BtheDestroyer/PICOnsole/README.md

# PICOnsole

Simple OS made from scratch for the Raspberry Pi Pico with the intention of being used to launch games.
