BtheDestroyer/PICOnsole/models/DPad.stl

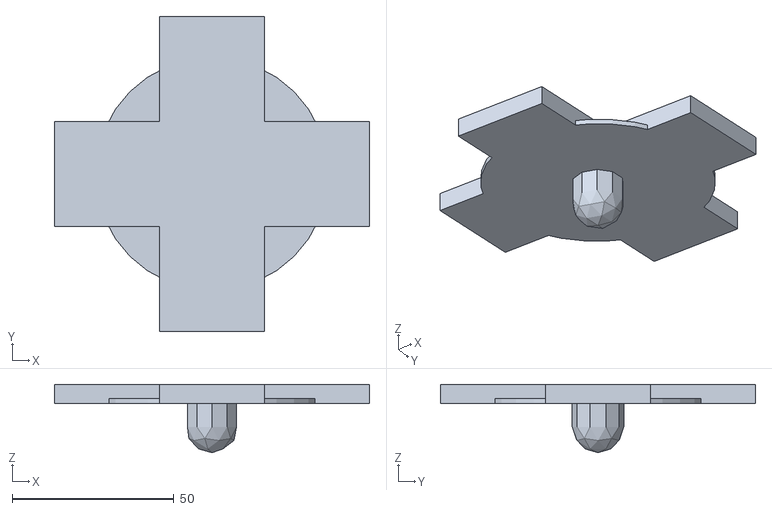
[picture p1: CAD file, 2023-11-23]
models/DPad.stl
97.5 x 97.5 x 21.2
