BtheDestroyer/PICOnsole/models/DevkitTestbench.stl

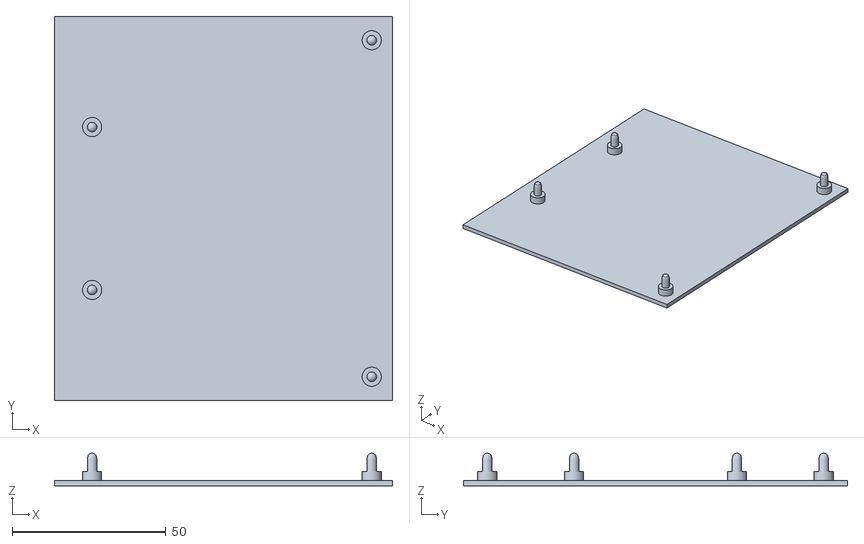
[picture p2: CAD file, 2023-11-23]
models/DevkitTestbench.stl
110.0 x 125.0 x 10.7
