BtheDestroyer/PICOnsole/(list of files, cad)

Other CAD files:
models/DPad.blend
models/DevkitTestbench.blend
