BtheDestroyer/PICOnsole/(threads)

Thread 4 (2023-02-04):

Button input

BtheDestroyer, 2023-02-04:
New class `InputMap` contains everything from the [prototype's `OS.inputs`](https://github.com/BtheDestroyer/PICOnsole/blob/main/Prototype/PICOnsole.py#L362)

New function `InputMap::evaluate` will replace the [prototype's `OS._update_input`](https://github.com/BtheDestroyer/PICOnsole/blob/main/Prototype/PICOnsole.py#L590)

Closed 2023-03-27.
