BtheDestroyer/PICOnsole/KiCad/Devkit/Hotswap Pico Hub/DevkitHotswapPicoHub.kicad_pcb

## KiCad design KiCad/Devkit/Hotswap Pico Hub/DevkitHotswapPicoHub.kicad_pcb (2023-11-23)

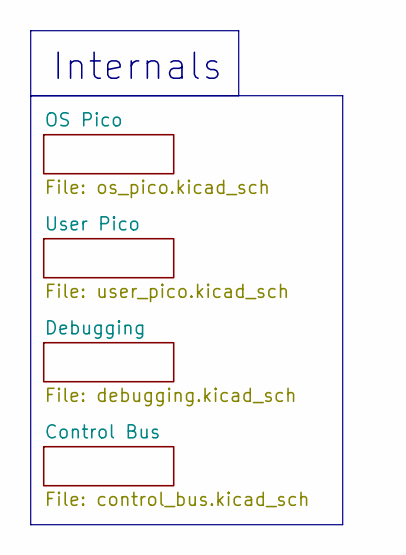
[picture p3: schematic DevkitHotswapPicoHub.kicad_sch, PICOnsole]

Notes on the sheet:
Internals

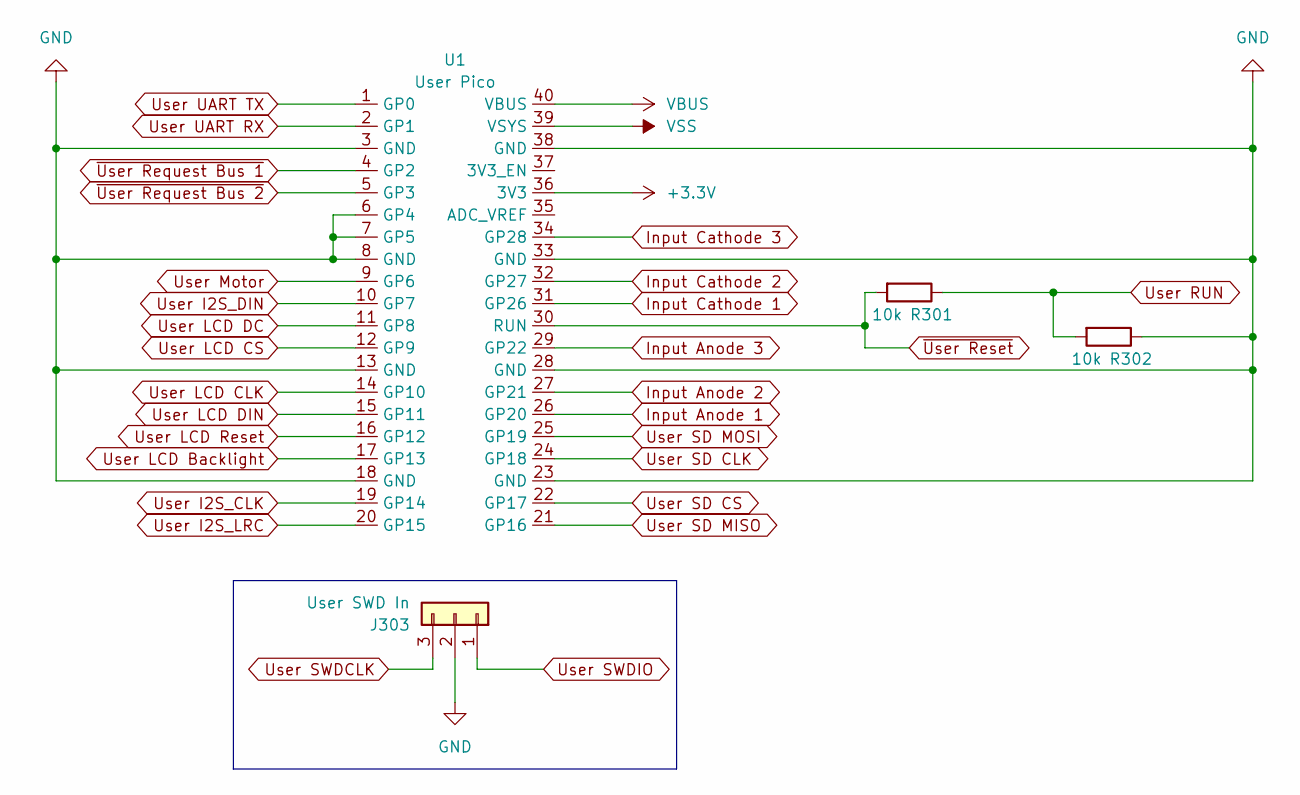
[picture p4: schematic user_pico.kicad_sch]

Parts:
J303: User SWD In; PinHeader_1x03_P2.54mm_Vertical
R301, R302: 10k; R_0805_2012Metric
U1: User Pico; Raspberry_Pi_Pico

Connections:
GND: J303.2, R302.1; also elsewhere on the board
User RUN: R301.1, R302.2; also elsewhere on the board
User SWDCLK: J303.3; also elsewhere on the board
User SWDIO: J303.1; also elsewhere on the board
~User Reset: R301.2; also elsewhere on the board

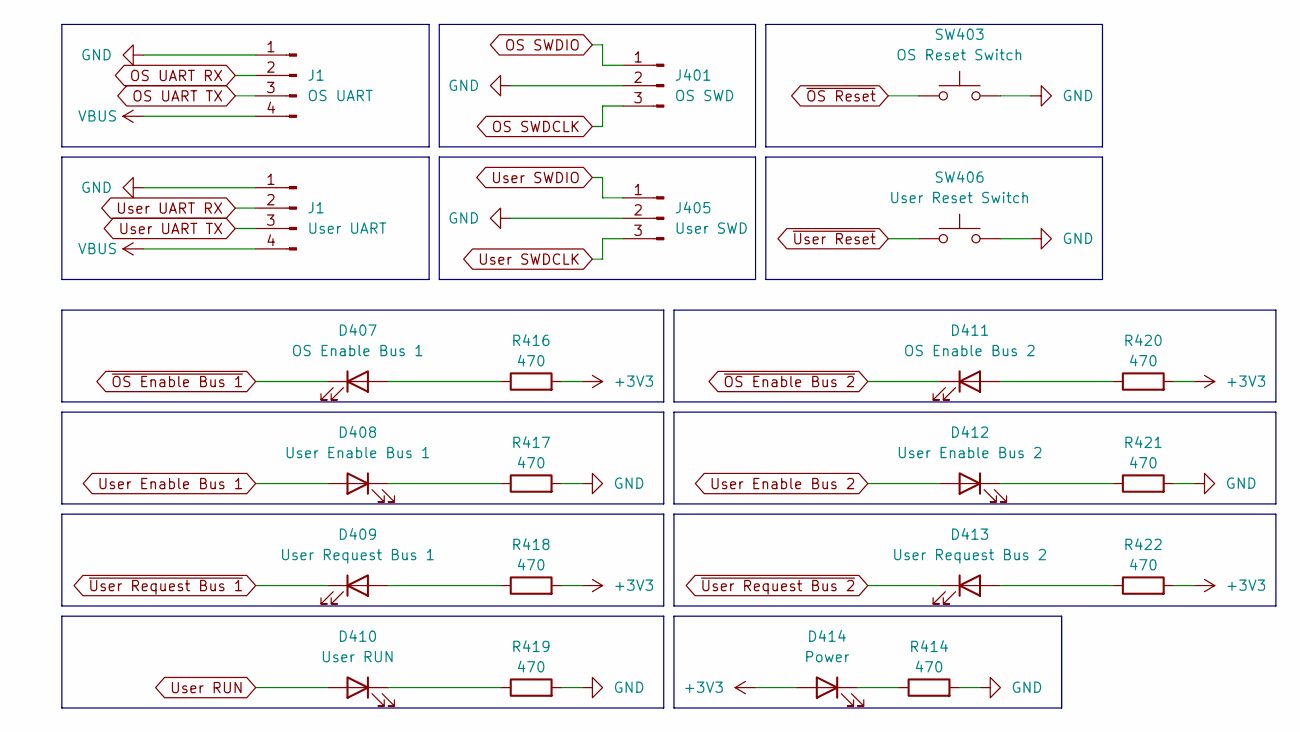
[picture p5: schematic debugging.kicad_sch]

Parts:
D407: OS Enable Bus 1; LED_D5.0mm
D408: User Enable Bus 1; LED_D5.0mm
D409: User Request Bus 1; LED_D5.0mm
D410: User RUN; LED_D5.0mm
D411: OS Enable Bus 2; LED_D5.0mm
D412: User Enable Bus 2; LED_D5.0mm
D413: User Request Bus 2; LED_D5.0mm
D414: Power; LED_D5.0mm
J1: OS UART; PinHeader_1x04_P2.54mm_Vertical
J401: OS SWD; PinSocket_1x03_P2.54mm_Vertical
J405: User SWD; PinSocket_1x03_P2.54mm_Vertical
R414, R416, R417, R418, R419, R420, R421, R422: 470; R_0805_2012Metric
SW403: OS Reset Switch; SW_PUSH-12mm
SW406: User Reset Switch; SW_PUSH-12mm

Connections:
GND: J401.2, J405.2, R414.2, R417.2, R419.2, R421.2, SW403.1, SW406.2; also elsewhere on the board
unnamed: D407.2 (A), R416.1
unnamed: D408.1 (K), R417.1
unnamed: D409.2 (A), R418.1
unnamed: D410.1 (K), R419.1
unnamed: D411.2 (A), R420.1
unnamed: D412.1 (K), R421.1
unnamed: D413.2 (A), R422.1
unnamed: D414.1 (K), R414.1
OS SWDCLK: J401.3; also elsewhere on the board
OS SWDIO: J401.1; also elsewhere on the board
User Enable Bus 1: D407.1 (K), D408.2 (A); also elsewhere on the board
User Enable Bus 2: D411.1 (K), D412.2 (A); also elsewhere on the board
User RUN: D410.2 (A); also elsewhere on the board
User SWDCLK: J405.3; also elsewhere on the board
User SWDIO: J405.1; also elsewhere on the board
~OS Reset: SW403.2; also elsewhere on the board
~User Request Bus 1: D409.1 (K); also elsewhere on the board
~User Request Bus 2: D413.1 (K); also elsewhere on the board
~User Reset: SW406.1; also elsewhere on the board

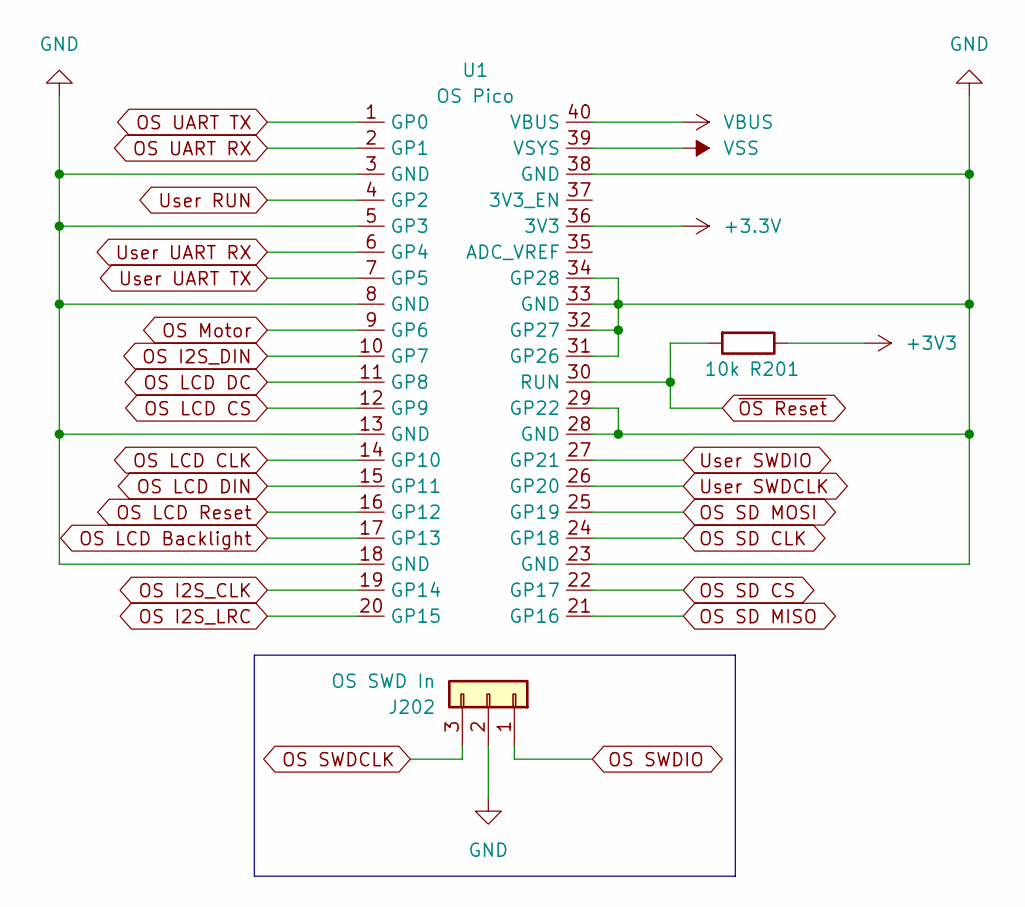
[picture p6: schematic os_pico.kicad_sch]

Parts:
J202: OS SWD In; PinHeader_1x03_P2.54mm_Vertical
R201: 10k; R_0805_2012Metric
U1: OS Pico; Raspberry_Pi_Pico

Connections:
GND: J202.2; also elsewhere on the board
OS SWDCLK: J202.3; also elsewhere on the board
OS SWDIO: J202.1; also elsewhere on the board
~OS Reset: R201.2; also elsewhere on the board

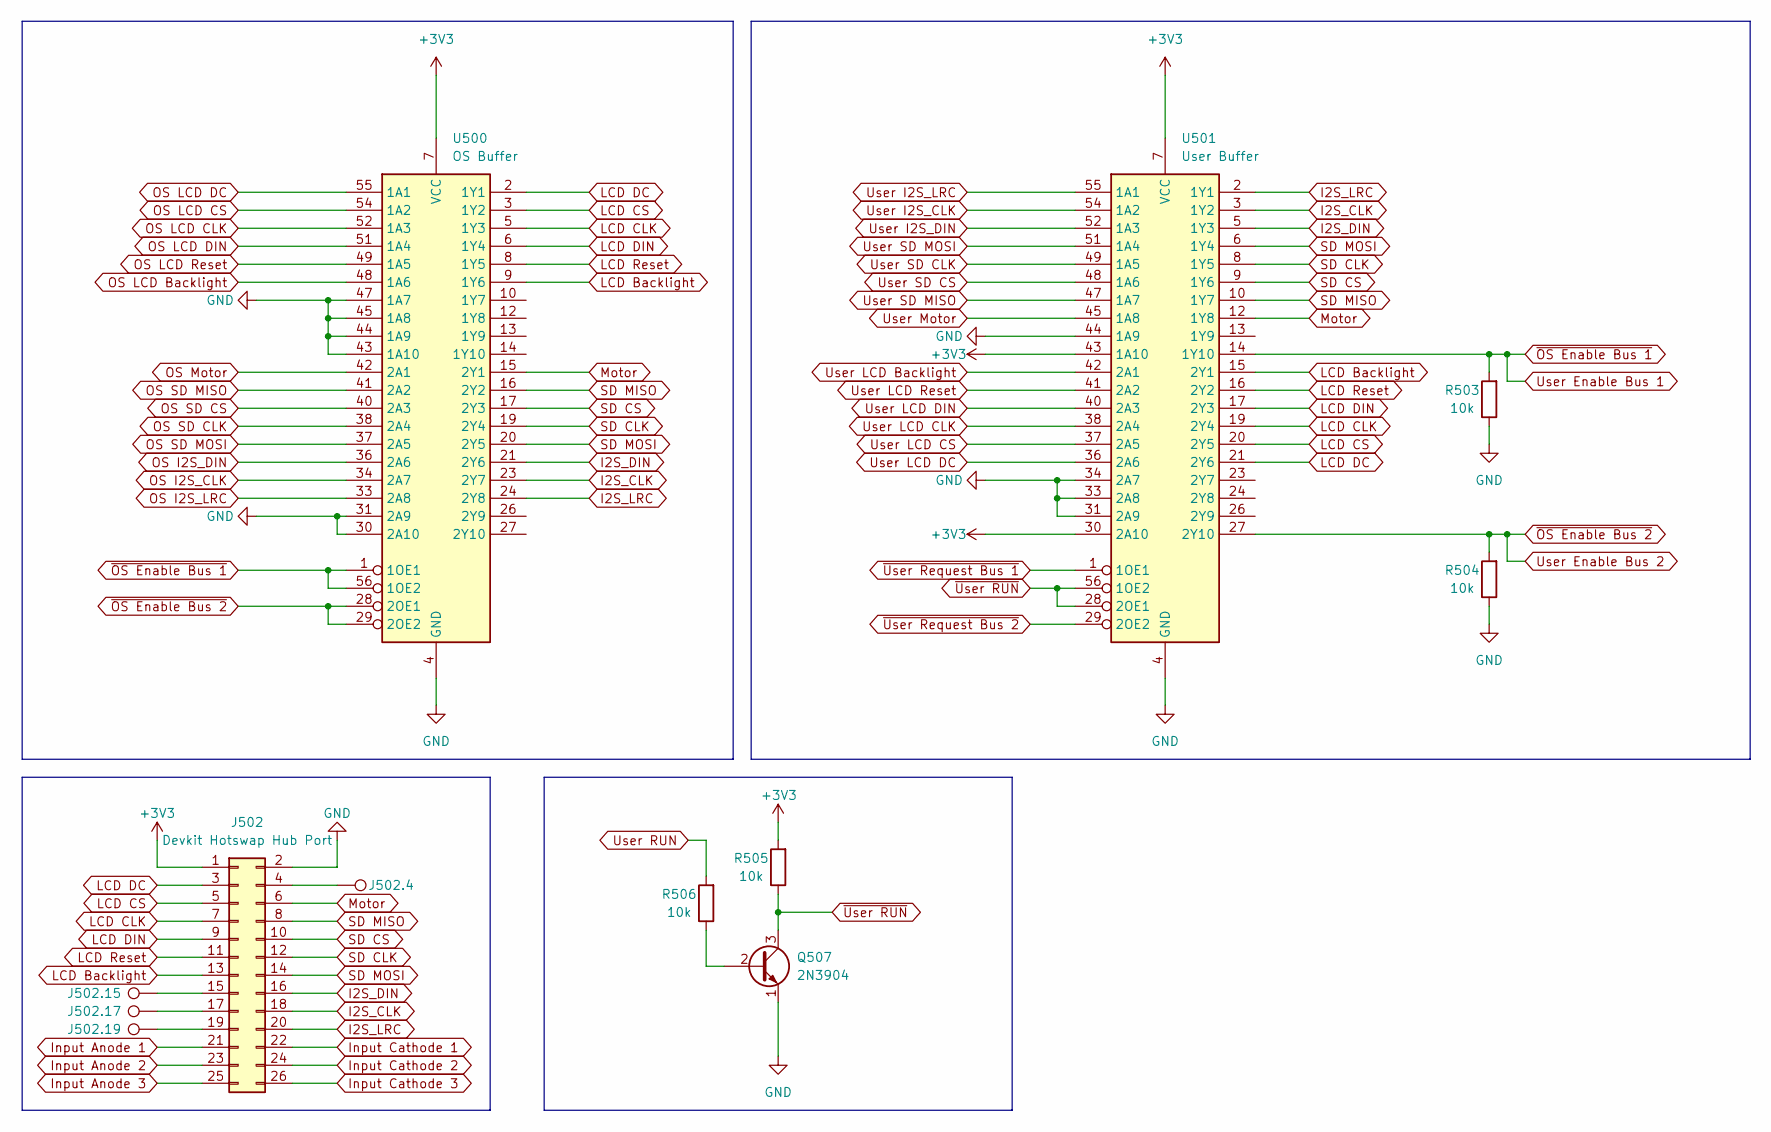
[picture p7: schematic control_bus.kicad_sch]

Parts:
J502: Devkit Hotswap Hub Port; PinHeader_2x13_P2.54mm_Vertical
J502.4, J502.15, J502.17, J502.19: TestPoint; TestPoint_Pad_1.5x1.5mm
Q507: 2N3904; TO-92_Inline
R503, R504, R505, R506: 10k; R_0805_2012Metric
U500: OS Buffer; TSSOP-56_6.1x14mm_P0.5mm
U501: User Buffer; TSSOP-56_6.1x14mm_P0.5mm

Connections:
GND: J502.2, Q507.1 (E), R503.1, R504.1, U500.4 (GND), U500.11 (GND), U500.18 (GND), U500.25 (GND), U500.30 (2A10), U500.31 (2A9), U500.32 (GND), U500.39 (GND), U500.43 (1A10), U500.44 (1A9), U500.45 (1A8), U500.46 (GND), U500.47 (1A7), U500.53 (GND), U501.4 (GND), U501.11 (GND), U501.18 (GND), U501.25 (GND), U501.31 (2A9), U501.32 (GND), U501.33 (2A8), U501.34 (2A7), U501.39 (GND), U501.44 (1A9), U501.46 (GND), U501.53 (GND); also elsewhere on the board
I2S_CLK: J502.18, U500.23 (2Y7), U501.3 (1Y2)
I2S_DIN: J502.16, U500.21 (2Y6), U501.5 (1Y3)
I2S_LRC: J502.20, U500.24 (2Y8), U501.2 (1Y1)
Input Anode 1: J502.21; also elsewhere on the board
Input Anode 2: J502.23; also elsewhere on the board
Input Anode 3: J502.25; also elsewhere on the board
Input Cathode 1: J502.22; also elsewhere on the board
Input Cathode 2: J502.24; also elsewhere on the board
Input Cathode 3: J502.26; also elsewhere on the board
LCD Backlight: J502.13, U500.9 (1Y6), U501.15 (2Y1)
LCD CLK: J502.7, U500.5 (1Y3), U501.19 (2Y4)
LCD CS: J502.5, U500.3 (1Y2), U501.20 (2Y5)
LCD DC: J502.3, U500.2 (1Y1), U501.21 (2Y6)
LCD DIN: J502.9, U500.6 (1Y4), U501.17 (2Y3)
LCD Reset: J502.11, U500.8 (1Y5), U501.16 (2Y2)
Motor: J502.6, U500.15 (2Y1), U501.12 (1Y8)
unnamed: J502.4, J502.4.1
unnamed: J502.15, J502.15.1
unnamed: J502.17, J502.17.1
unnamed: J502.19, J502.19.1
unnamed: Q507.2 (B), R506.1
OS I2S_CLK: U500.34 (2A7); also elsewhere on the board
OS I2S_DIN: U500.36 (2A6); also elsewhere on the board
OS I2S_LRC: U500.33 (2A8); also elsewhere on the board
OS LCD Backlight: U500.48 (1A6); also elsewhere on the board
OS LCD CLK: U500.52 (1A3); also elsewhere on the board
OS LCD CS: U500.54 (1A2); also elsewhere on the board
OS LCD DC: U500.55 (1A1); also elsewhere on the board
OS LCD DIN: U500.51 (1A4); also elsewhere on the board
OS LCD Reset: U500.49 (1A5); also elsewhere on the board
OS Motor: U500.42 (2A1); also elsewhere on the board
OS SD CLK: U500.38 (2A4); also elsewhere on the board
OS SD CS: U500.40 (2A3); also elsewhere on the board
OS SD MISO: U500.41 (2A2); also elsewhere on the board
OS SD MOSI: U500.37 (2A5); also elsewhere on the board
SD CLK: J502.12, U500.19 (2Y4), U501.8 (1Y5)
SD CS: J502.10, U500.17 (2Y3), U501.9 (1Y6)
SD MISO: J502.8, U500.16 (2Y2), U501.10 (1Y7)
SD MOSI: J502.14, U500.20 (2Y5), U501.6 (1Y4)
User Enable Bus 1: R503.2, U500.1 (1OE1), U500.56 (1OE2), U501.14 (1Y10); also elsewhere on the board
User Enable Bus 2: R504.2, U500.28 (2OE1), U500.29 (2OE2), U501.27 (2Y10); also elsewhere on the board
User I2S_CLK: U501.54 (1A2); also elsewhere on the board
User I2S_DIN: U501.52 (1A3); also elsewhere on the board
User I2S_LRC: U501.55 (1A1); also elsewhere on the board
User LCD Backlight: U501.42 (2A1); also elsewhere on the board
User LCD CLK: U501.38 (2A4); also elsewhere on the board
User LCD CS: U501.37 (2A5); also elsewhere on the board
User LCD DC: U501.36 (2A6); also elsewhere on the board
User LCD DIN: U501.40 (2A3); also elsewhere on the board
User LCD Reset: U501.41 (2A2); also elsewhere on the board
User Motor: U501.45 (1A8); also elsewhere on the board
User RUN: R506.2; also elsewhere on the board
User SD CLK: U501.49 (1A5); also elsewhere on the board
User SD CS: U501.48 (1A6); also elsewhere on the board
User SD MISO: U501.47 (1A7); also elsewhere on the board
User SD MOSI: U501.51 (1A4); also elsewhere on the board
~User RUN: Q507.3 (C), R505.1, U501.28 (2OE1), U501.56 (1OE2)
~User Request Bus 1: U501.1 (1OE1); also elsewhere on the board
~User Request Bus 2: U501.29 (2OE2); also elsewhere on the board

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
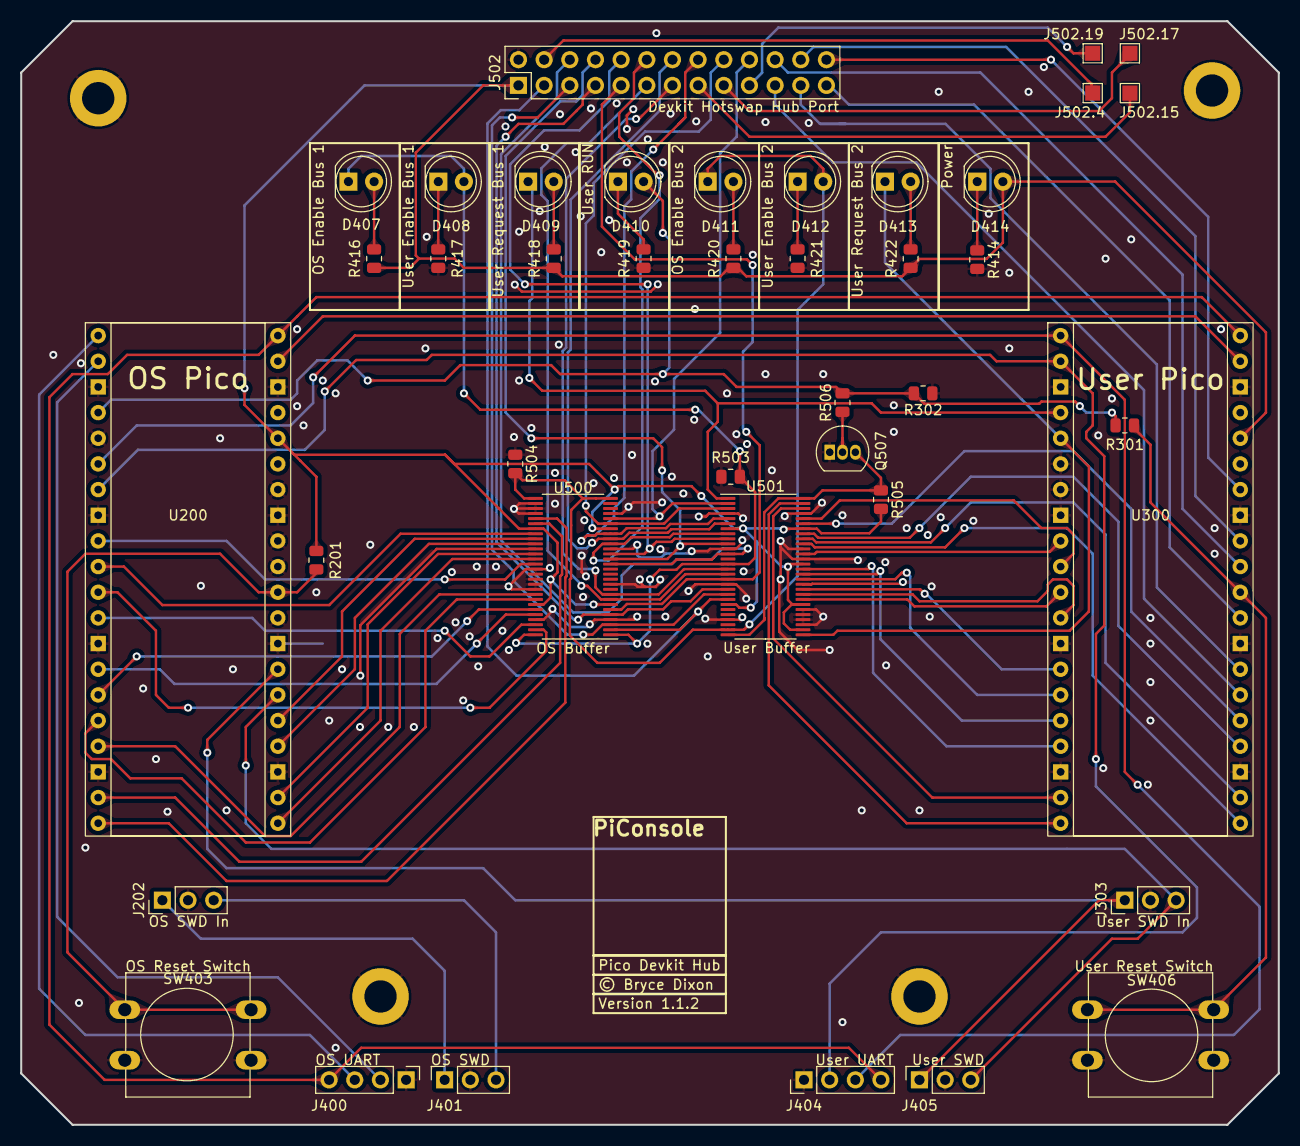
[picture p8: board DevkitHotswapPicoHub.kicad_pcb from above]

Board: 2 copper layers, 124.5 x 109.2 mm, 41 parts (0 on the bottom side), 81 nets.

Other parts of the board:
J400: OS UART; PinHeader_1x04_P2.54mm_Vertical
J404: User UART; PinHeader_1x04_P2.54mm_Vertical
U200: OS Pico; Raspberry_Pi_Pico
U300: User Pico; Raspberry_Pi_Pico

Their connections:
GND: J400.1, J404.1, U200.3 (GND), U200.5 (GP3), U200.8 (GND), U200.13 (GND), U200.18 (GND), U200.23 (GND), U200.28 (GND), U200.29 (GP22), U200.31 (GP26), U200.32 (GP27), U200.33 (GND), U200.34 (GP28), U200.38 (GND), U300.3 (GND), U300.6 (GP4), U300.7 (GP5), U300.8 (GND), U300.13 (GND), U300.18 (GND), U300.23 (GND), U300.28 (GND), U300.33 (GND), U300.38 (GND); also elsewhere on the board
Input Anode 1: U300.26 (GP20); also elsewhere on the board
Input Anode 2: U300.27 (GP21); also elsewhere on the board
Input Anode 3: U300.29 (GP22); also elsewhere on the board
Input Cathode 1: U300.31 (GP26); also elsewhere on the board
Input Cathode 2: U300.32 (GP27); also elsewhere on the board
Input Cathode 3: U300.34 (GP28); also elsewhere on the board
OS I2S_CLK: U200.19 (GP14); also elsewhere on the board
OS I2S_DIN: U200.10 (GP7); also elsewhere on the board
OS I2S_LRC: U200.20 (GP15); also elsewhere on the board
OS LCD Backlight: U200.17 (GP13); also elsewhere on the board
OS LCD CLK: U200.14 (GP10); also elsewhere on the board
OS LCD CS: U200.12 (GP9); also elsewhere on the board
OS LCD DC: U200.11 (GP8); also elsewhere on the board
OS LCD DIN: U200.15 (GP11); also elsewhere on the board
OS LCD Reset: U200.16 (GP12); also elsewhere on the board
OS Motor: U200.9 (GP6); also elsewhere on the board
OS SD CLK: U200.24 (GP18); also elsewhere on the board
OS SD CS: U200.22 (GP17); also elsewhere on the board
OS SD MISO: U200.21 (GP16); also elsewhere on the board
OS SD MOSI: U200.25 (GP19); also elsewhere on the board
OS UART RX: J400.2, U200.2 (GP1)
OS UART TX: J400.3, U200.1 (GP0)
User I2S_CLK: U300.19 (GP14); also elsewhere on the board
User I2S_DIN: U300.10 (GP7); also elsewhere on the board
User I2S_LRC: U300.20 (GP15); also elsewhere on the board
User LCD Backlight: U300.17 (GP13); also elsewhere on the board
User LCD CLK: U300.14 (GP10); also elsewhere on the board
User LCD CS: U300.12 (GP9); also elsewhere on the board
User LCD DC: U300.11 (GP8); also elsewhere on the board
User LCD DIN: U300.15 (GP11); also elsewhere on the board
User LCD Reset: U300.16 (GP12); also elsewhere on the board
User Motor: U300.9 (GP6); also elsewhere on the board
User RUN: U200.4 (GP2); also elsewhere on the board
User SD CLK: U300.24 (GP18); also elsewhere on the board
User SD CS: U300.22 (GP17); also elsewhere on the board
User SD MISO: U300.21 (GP16); also elsewhere on the board
User SD MOSI: U300.25 (GP19); also elsewhere on the board
User SWDCLK: U200.26 (GP20); also elsewhere on the board
User SWDIO: U200.27 (GP21); also elsewhere on the board
User UART RX: J404.2, U200.6 (GP4), U300.2 (GP1)
User UART TX: J404.3, U200.7 (GP5), U300.1 (GP0)
VBUS: J400.4, J404.4, U200.40 (VBUS), U300.40 (VBUS)
VSS: U200.39 (VSYS), U300.39 (VSYS)
~OS Reset: U200.30 (RUN); also elsewhere on the board
~User Request Bus 1: U300.4 (GP2); also elsewhere on the board
~User Request Bus 2: U300.5 (GP3); also elsewhere on the board
~User Reset: U300.30 (RUN); also elsewhere on the board
