BtheDestroyer/PICOnsole/KiCad/Devkit/Handheld Interface/HandheldInterface.kicad_pcb

## KiCad design KiCad/Devkit/Handheld Interface/HandheldInterface.kicad_pcb (2023-10-20)

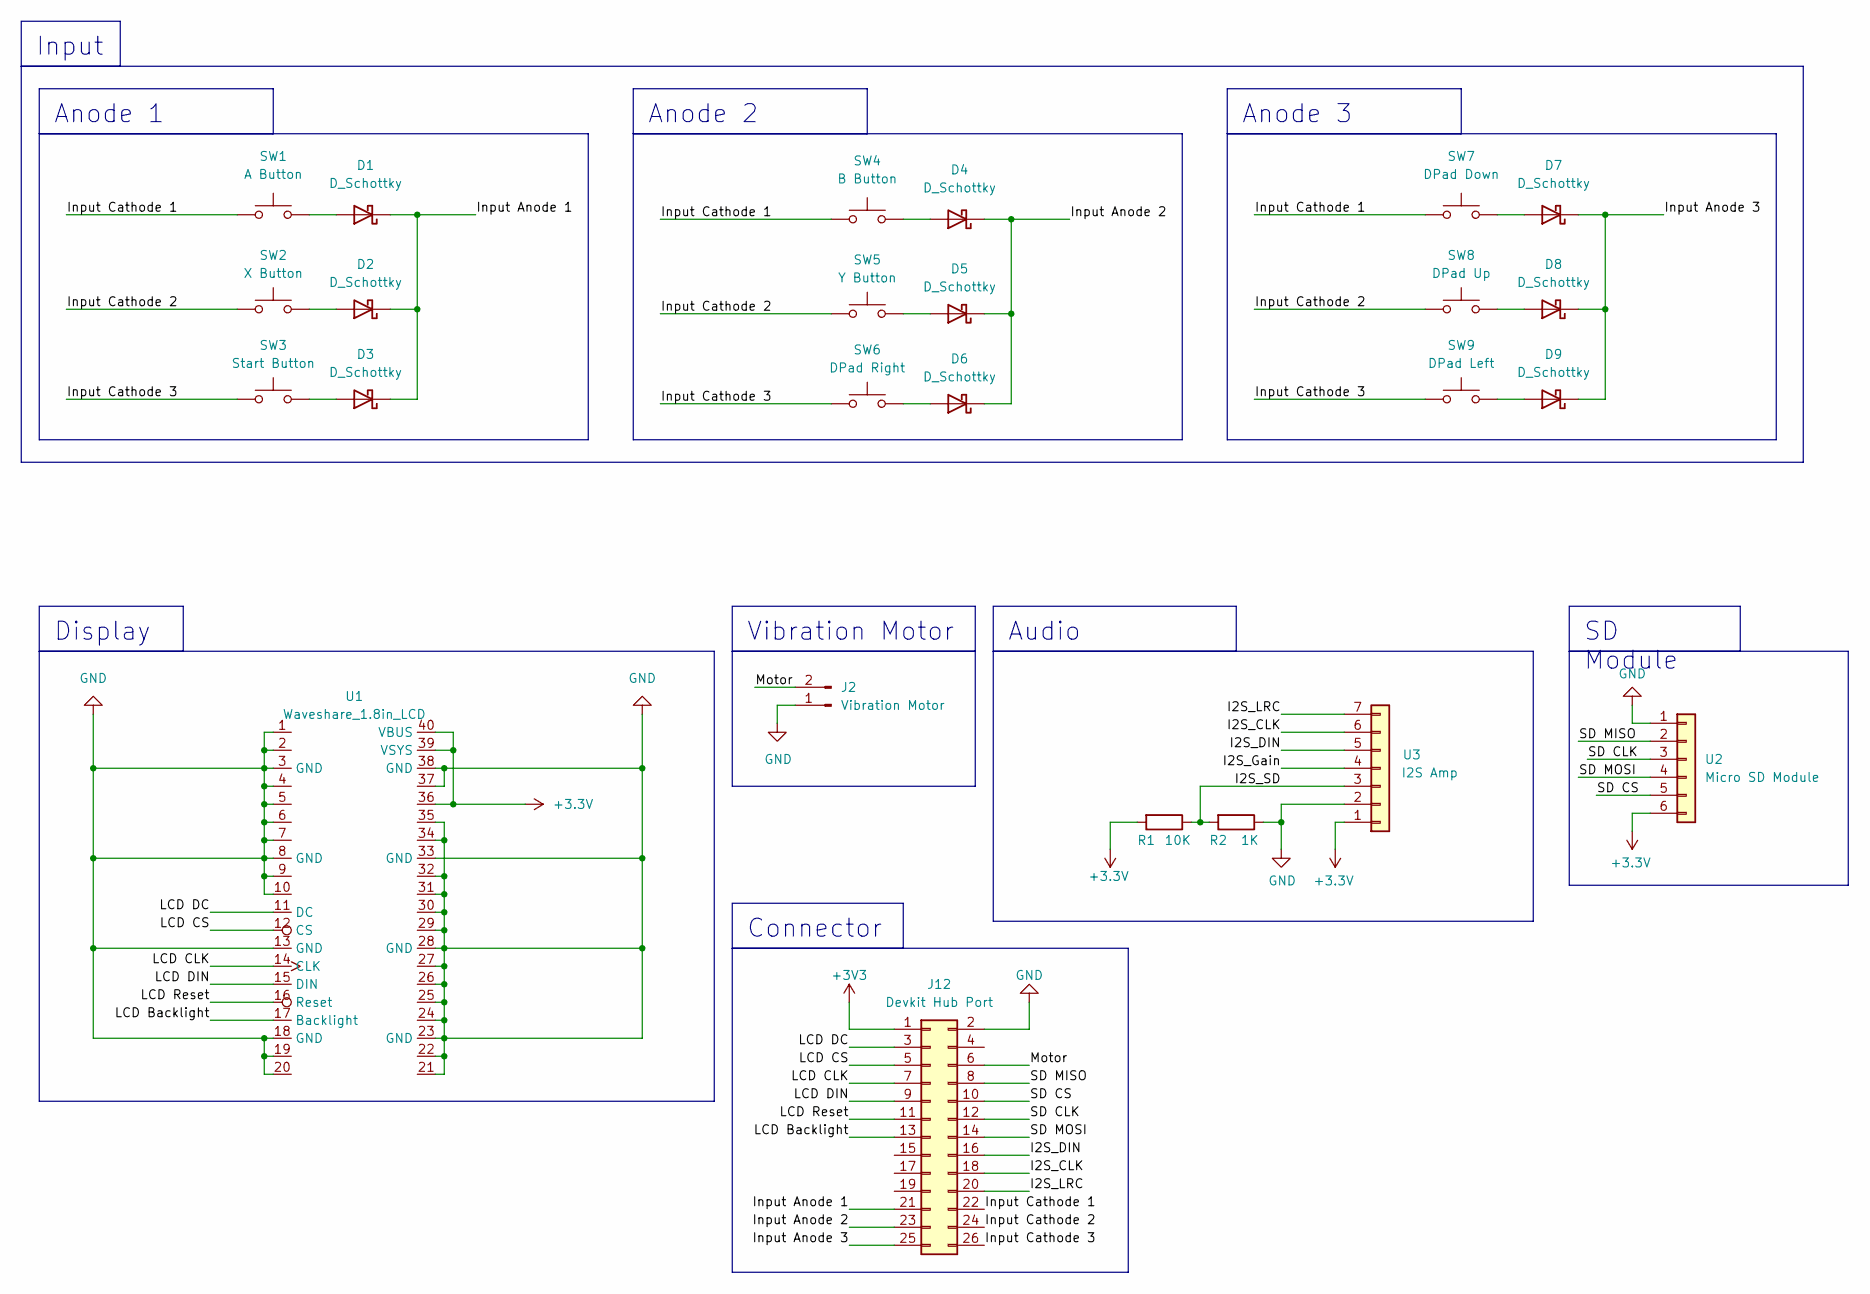
[picture p9: schematic HandheldInterface.kicad_sch, PICOnsole]

Parts:
D1, D2, D3, D4, D5, D6, D7, D8, D9: D_Schottky; D_A-405_P10.16mm_Horizontal
J2: Vibration Motor; PinHeader_1x02_P2.54mm_Vertical
J12: Devkit Hub Port; PinHeader_2x13_P2.54mm_Vertical
R1: 10K; R_0805_2012Metric_Pad1.20x1.40mm_HandSolder
R2: 1K; R_0805_2012Metric_Pad1.20x1.40mm_HandSolder
SW1: A Button; SW_PUSH-12mm
SW2: X Button; SW_PUSH-12mm
SW3: Start Button; SW_PUSH_6mm
SW4: B Button; SW_PUSH-12mm
SW5: Y Button; SW_PUSH-12mm
SW6: DPad Right; SW_PUSH-12mm
SW7: DPad Down; SW_PUSH-12mm
SW8: DPad Up; SW_PUSH-12mm
SW9: DPad Left; SW_PUSH-12mm
U1: Waveshare_1.8in_LCD
U2: Micro SD Module; PinHeader_1x06_P2.54mm_Vertical
U3: I2S Amp; PinHeader_1x07_P2.54mm_Vertical

Connections:
/I2S_CLK: U3.6; also elsewhere on the board
/I2S_DIN: U3.5; also elsewhere on the board
/I2S_Gain: U3.4
/I2S_LRC: U3.7; also elsewhere on the board
/I2S_SD: R1.1, R2.2, U3.3
/Input Anode 1: D1.1 (K), D2.1 (K), D3.1 (K); also elsewhere on the board
/Input Anode 2: D4.1 (K), D5.1 (K), D6.1 (K); also elsewhere on the board
/Input Anode 3: D7.1 (K), D8.1 (K), D9.1 (K); also elsewhere on the board
/Input Cathode 1: SW1.1, SW4.1, SW7.1; also elsewhere on the board
/Input Cathode 2: SW2.1, SW5.1, SW8.1; also elsewhere on the board
/Input Cathode 3: SW3.1, SW6.1, SW9.1; also elsewhere on the board
/LCD Backlight: U1.17 (Backlight); also elsewhere on the board
/LCD CLK: U1.14 (CLK); also elsewhere on the board
/LCD CS: U1.12 (CS); also elsewhere on the board
/LCD DC: U1.11 (DC); also elsewhere on the board
/LCD DIN: U1.15 (DIN); also elsewhere on the board
/LCD Reset: U1.16 (Reset); also elsewhere on the board
/Motor: J2.2; also elsewhere on the board
/SD CLK: U2.3; also elsewhere on the board
/SD CS: U2.5; also elsewhere on the board
/SD MISO: U2.2; also elsewhere on the board
/SD MOSI: U2.4; also elsewhere on the board
GND: J2.1, R2.1, U1.1, U1.2, U1.3 (GND), U1.4, U1.5, U1.6, U1.7, U1.8 (GND), U1.9, U1.10, U1.13 (GND), U1.18 (GND), U1.19, U1.20, U1.21, U1.22, U1.23 (GND), U1.24, U1.25, U1.26, U1.27, U1.28 (GND), U1.29, U1.30, U1.31, U1.32, U1.33 (GND), U1.34, U1.35, U1.37, U1.38 (GND), U2.1, U3.2; also elsewhere on the board
unnamed: D1.2 (A), SW1.2
unnamed: D2.2 (A), SW2.2
unnamed: D3.2 (A), SW3.2
unnamed: D4.2 (A), SW4.2
unnamed: D5.2 (A), SW5.2
unnamed: D6.2 (A), SW6.2
unnamed: D7.2 (A), SW7.2
unnamed: D8.2 (A), SW8.2
unnamed: D9.2 (A), SW9.2

Notes on the sheet:
Input
Connector
Anode 3
Anode 2
Anode 1
Display
Vibration Motor
SD Module
Audio

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
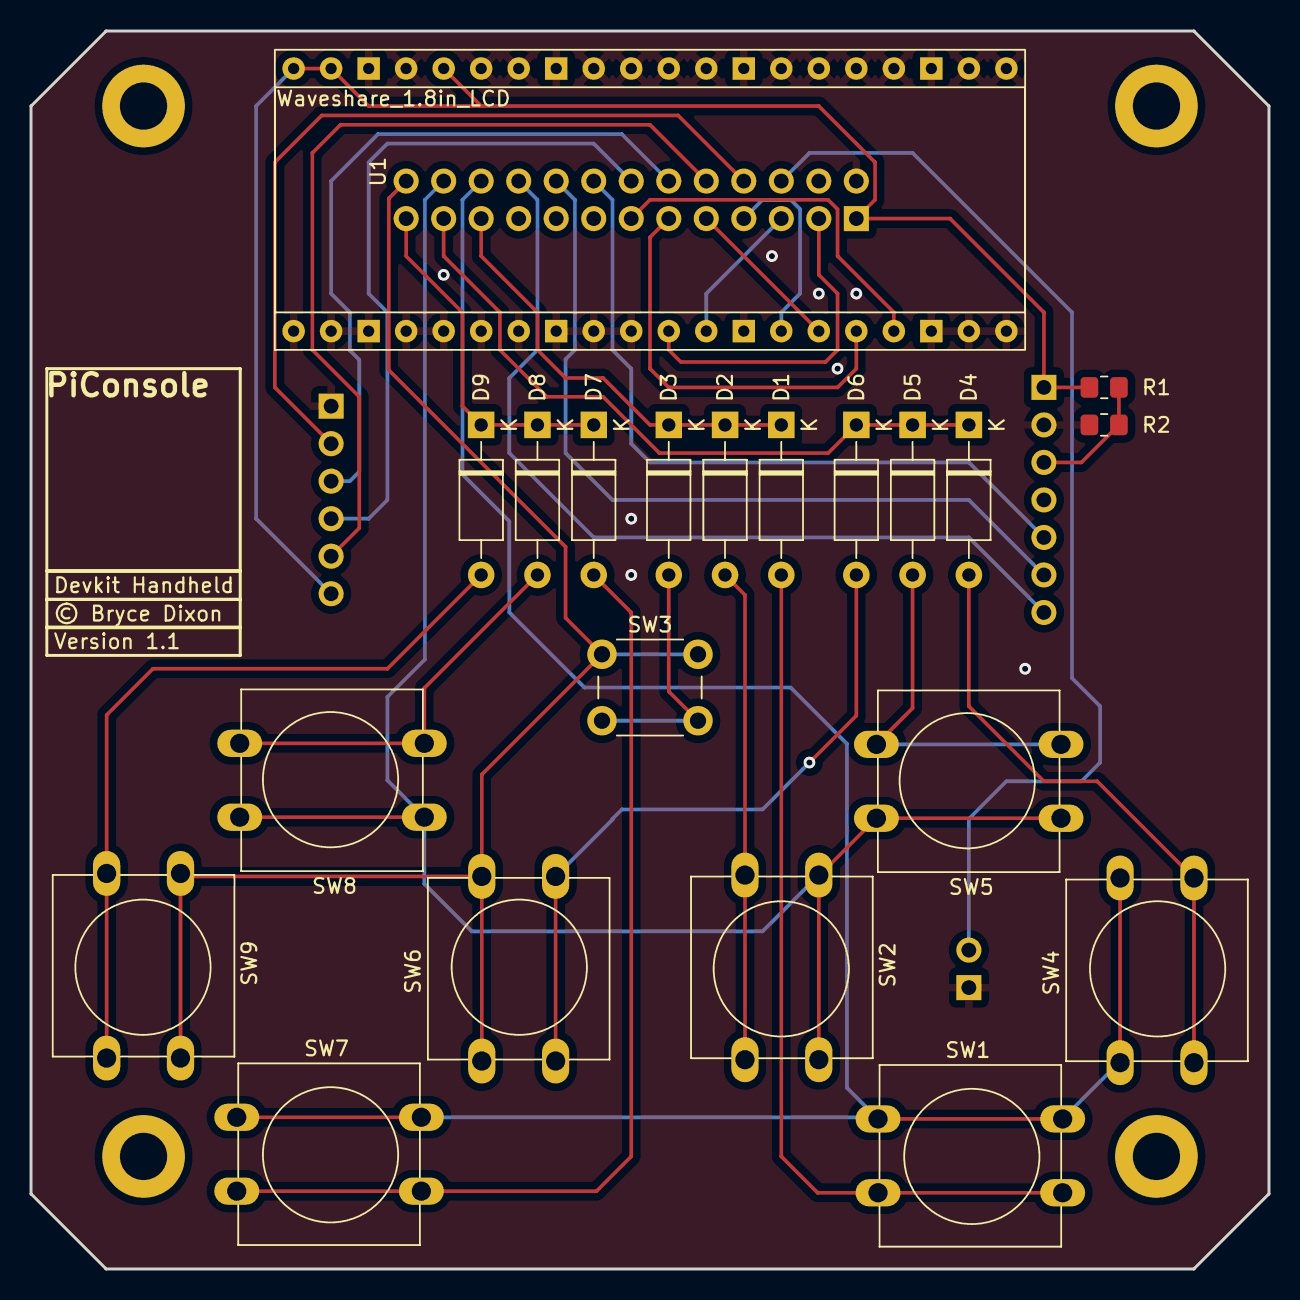
[picture p10: board HandheldInterface.kicad_pcb from above]

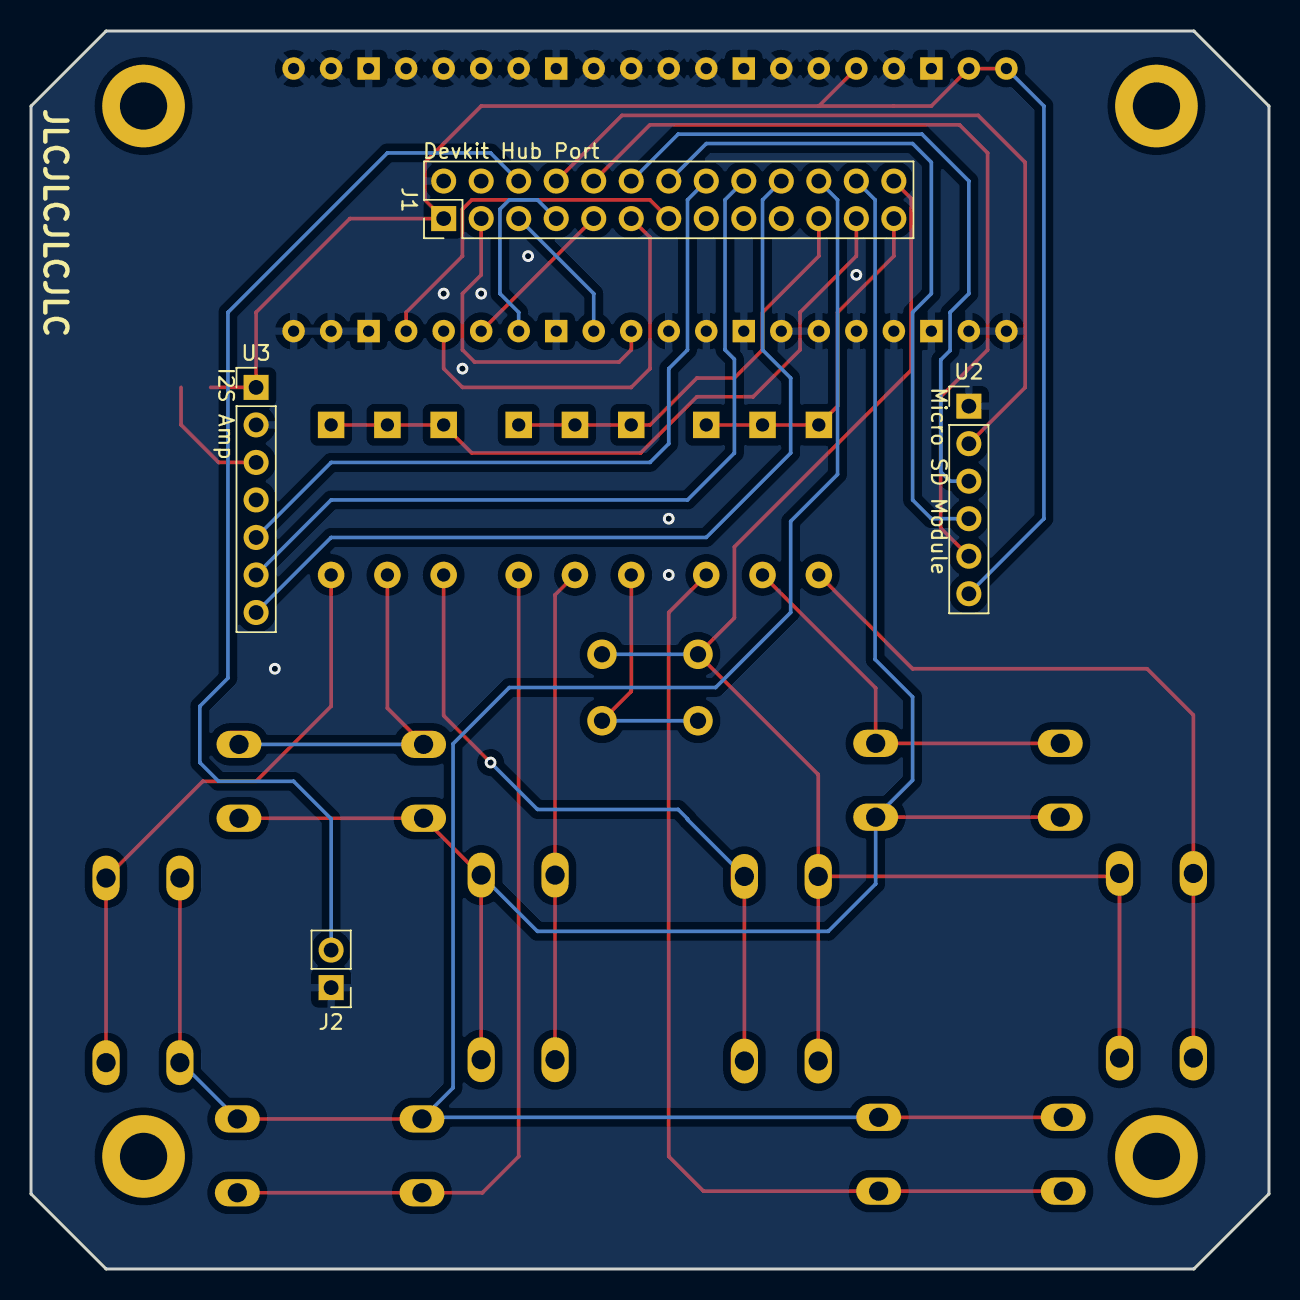
[picture p11: board HandheldInterface.kicad_pcb from below]

Board: 2 copper layers, 83.8 x 83.8 mm, 25 parts (4 on the bottom side), 32 nets.

Other parts of the board:
J1: Devkit Hub Port; PinHeader_2x13_P2.54mm_Vertical

Their connections:
/I2S_CLK: J1.18; also elsewhere on the board
/I2S_DIN: J1.16; also elsewhere on the board
/I2S_LRC: J1.20; also elsewhere on the board
/Input Anode 1: J1.21; also elsewhere on the board
/Input Anode 2: J1.23; also elsewhere on the board
/Input Anode 3: J1.25; also elsewhere on the board
/Input Cathode 1: J1.22; also elsewhere on the board
/Input Cathode 2: J1.24; also elsewhere on the board
/Input Cathode 3: J1.26; also elsewhere on the board
/LCD Backlight: J1.13; also elsewhere on the board
/LCD CLK: J1.7; also elsewhere on the board
/LCD CS: J1.5; also elsewhere on the board
/LCD DC: J1.3; also elsewhere on the board
/LCD DIN: J1.9; also elsewhere on the board
/LCD Reset: J1.11; also elsewhere on the board
/Motor: J1.6; also elsewhere on the board
/SD CLK: J1.12; also elsewhere on the board
/SD CS: J1.10; also elsewhere on the board
/SD MISO: J1.8; also elsewhere on the board
/SD MOSI: J1.14; also elsewhere on the board
GND: J1.2; also elsewhere on the board
