BtheDestroyer/PICOnsole/KiCad/PICOnsole/buttons.kicad_sch

## KiCad design KiCad/PICOnsole/buttons.kicad_sch (2023-10-20)

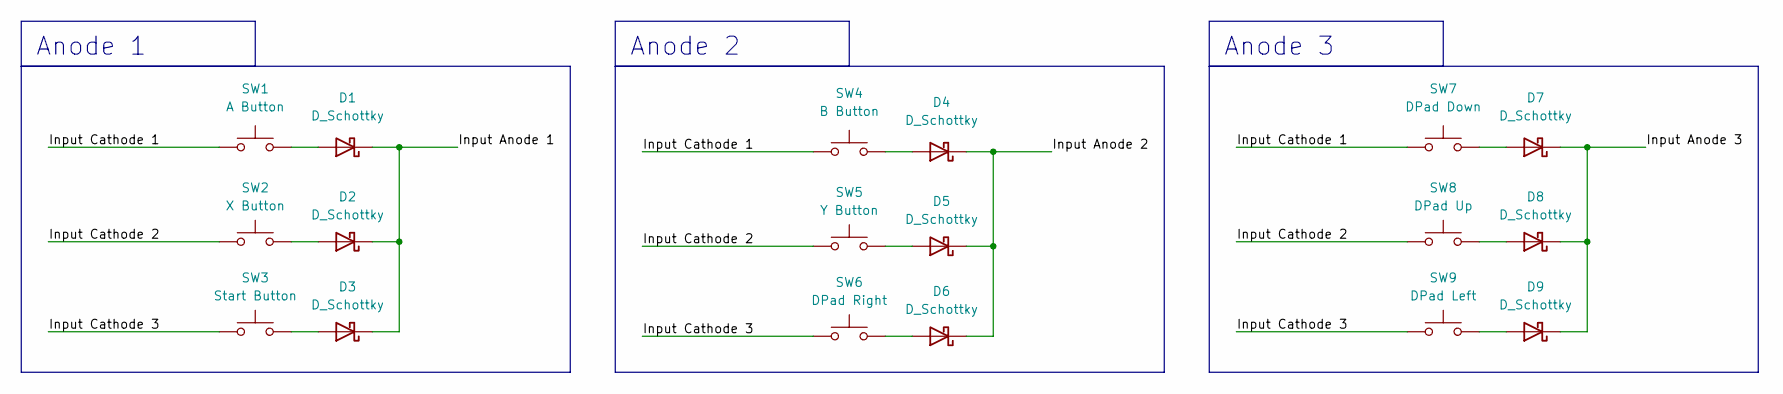
[picture p12: schematic buttons.kicad_sch]

Parts:
D1, D2, D3, D4, D5, D6, D7, D8, D9: D_Schottky; D_A-405_P10.16mm_Horizontal
SW1: A Button; SW_PUSH-12mm
SW2: X Button; SW_PUSH-12mm
SW3: Start Button; SW_PUSH_6mm
SW4: B Button; SW_PUSH-12mm
SW5: Y Button; SW_PUSH-12mm
SW6: DPad Right; SW_PUSH-12mm
SW7: DPad Down; SW_PUSH-12mm
SW8: DPad Up; SW_PUSH-12mm
SW9: DPad Left; SW_PUSH-12mm

Connections:
Input Anode 1: D1.1 (K), D2.1 (K), D3.1 (K)
Input Anode 2: D4.1 (K), D5.1 (K), D6.1 (K)
Input Anode 3: D7.1 (K), D8.1 (K), D9.1 (K)
Input Cathode 1: SW1.1, SW4.1, SW7.1
Input Cathode 2: SW2.1, SW5.1, SW8.1
Input Cathode 3: SW3.1, SW6.1, SW9.1
unnamed: D1.2 (A), SW1.2
unnamed: D2.2 (A), SW2.2
unnamed: D3.2 (A), SW3.2
unnamed: D4.2 (A), SW4.2
unnamed: D5.2 (A), SW5.2
unnamed: D6.2 (A), SW6.2
unnamed: D7.2 (A), SW7.2
unnamed: D8.2 (A), SW8.2
unnamed: D9.2 (A), SW9.2

Notes on the sheet:
Anode 3
Anode 2
Anode 1
