BtheDestroyer/PICOnsole/KiCad/PICOnsole/control_bus.kicad_sch

## KiCad design KiCad/PICOnsole/control_bus.kicad_sch (2023-10-20)

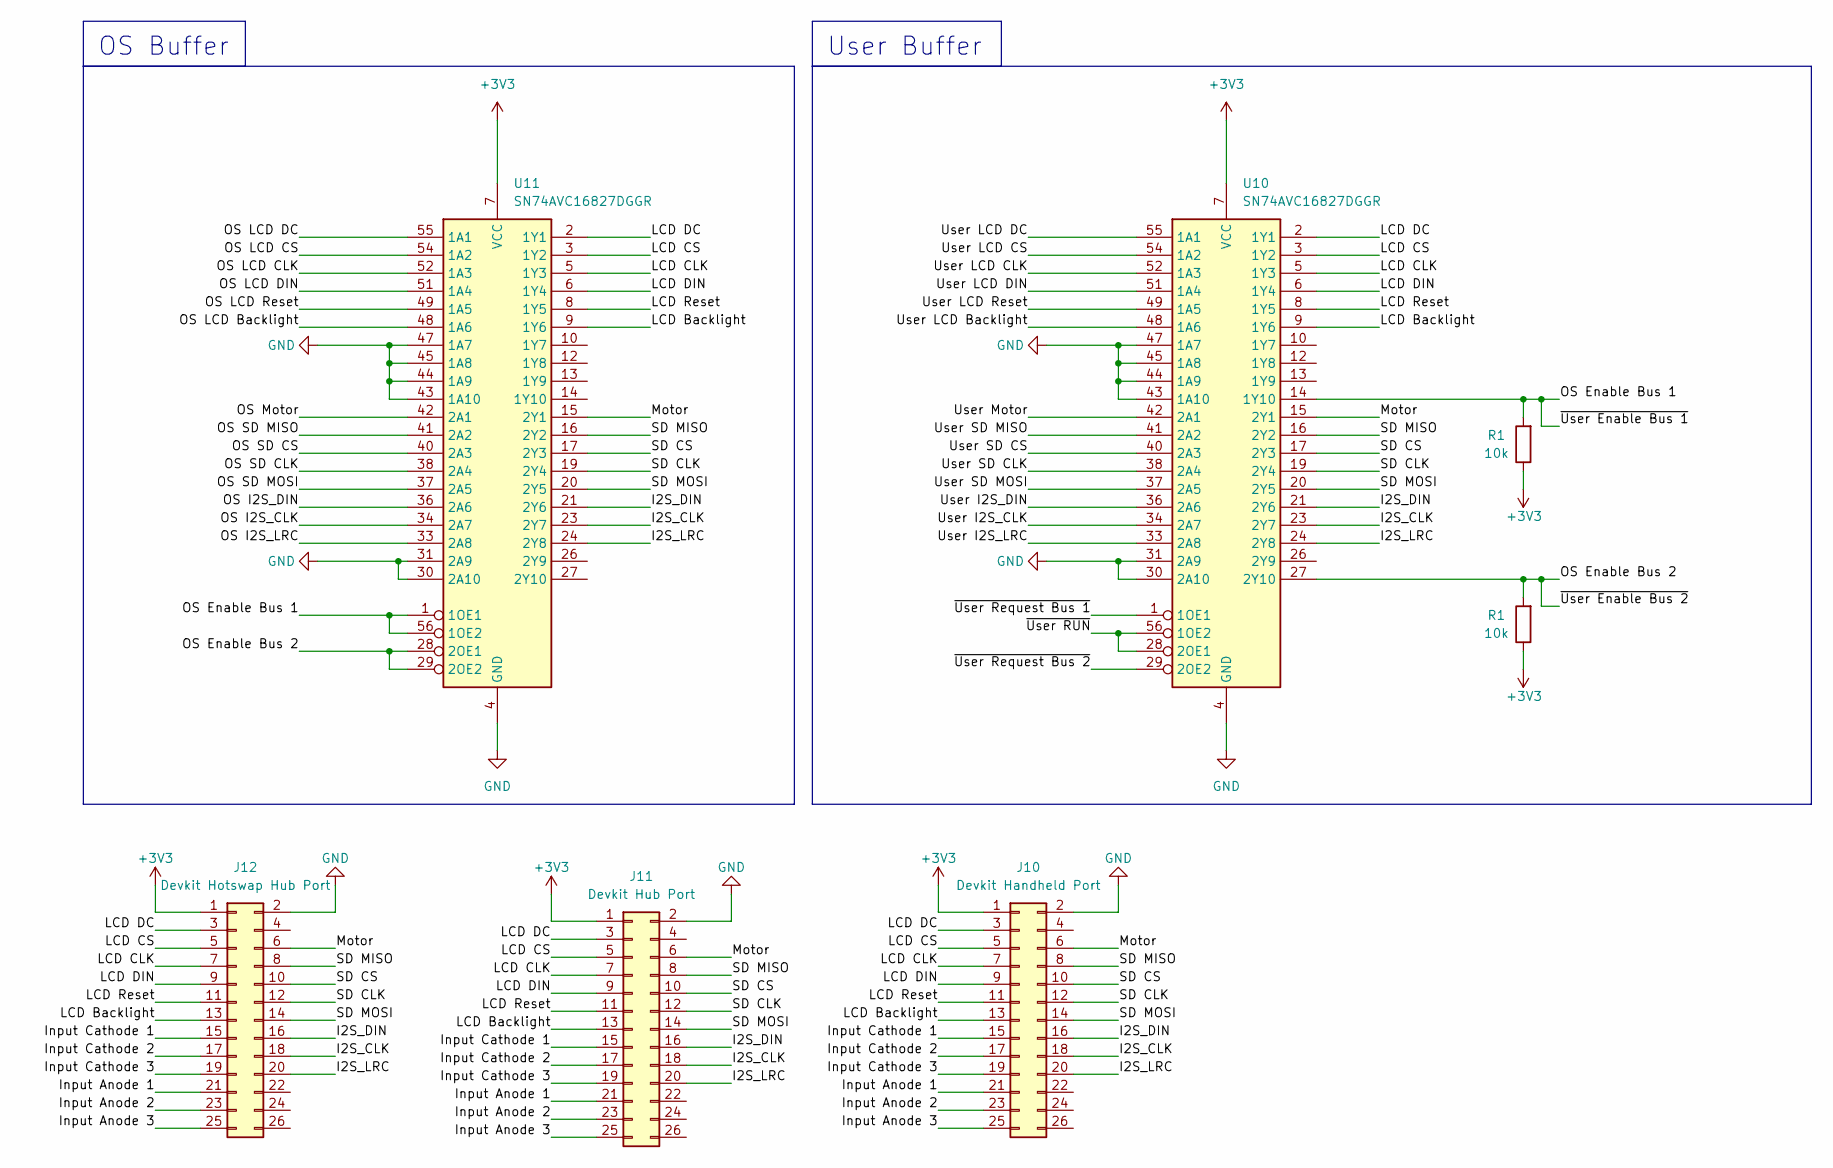
[picture p13: schematic control_bus.kicad_sch]

Parts:
J10: Devkit Handheld Port
J11: Devkit Hub Port
J12: Devkit Hotswap Hub Port
R1: 10k; R_0805_2012Metric
U10, U11: SN74AVC16827DGGR; TSSOP-56_6.1x14mm_P0.5mm

Connections:
+3V3: J10.1, J11.1, J12.1, R1.1, U10.7 (VCC), U10.22 (VCC), U10.35 (VCC), U10.50 (VCC), U11.7 (VCC), U11.22 (VCC), U11.35 (VCC), U11.50 (VCC)
GND: J10.2, J11.2, J12.2, U10.4 (GND), U10.11 (GND), U10.18 (GND), U10.25 (GND), U10.30 (2A10), U10.31 (2A9), U10.32 (GND), U10.39 (GND), U10.43 (1A10), U10.44 (1A9), U10.45 (1A8), U10.46 (GND), U10.47 (1A7), U10.53 (GND), U11.4 (GND), U11.11 (GND), U11.18 (GND), U11.25 (GND), U11.30 (2A10), U11.31 (2A9), U11.32 (GND), U11.39 (GND), U11.43 (1A10), U11.44 (1A9), U11.45 (1A8), U11.46 (GND), U11.47 (1A7), U11.53 (GND)
I2S_CLK: J10.18, J11.18, J12.18, U10.23 (2Y7), U11.23 (2Y7)
I2S_DIN: J10.16, J11.16, J12.16, U10.21 (2Y6), U11.21 (2Y6)
I2S_LRC: J10.20, J11.20, J12.20, U10.24 (2Y8), U11.24 (2Y8)
Input Anode 1: J10.21, J11.21, J12.21
Input Anode 2: J10.23, J11.23, J12.23
Input Anode 3: J10.25, J11.25, J12.25
Input Cathode 1: J10.15, J11.15, J12.15
Input Cathode 2: J10.17, J11.17, J12.17
Input Cathode 3: J10.19, J11.19, J12.19
LCD Backlight: J10.13, J11.13, J12.13, U10.9 (1Y6), U11.9 (1Y6)
LCD CLK: J10.7, J11.7, J12.7, U10.5 (1Y3), U11.5 (1Y3)
LCD CS: J10.5, J11.5, J12.5, U10.3 (1Y2), U11.3 (1Y2)
LCD DC: J10.3, J11.3, J12.3, U10.2 (1Y1), U11.2 (1Y1)
LCD DIN: J10.9, J11.9, J12.9, U10.6 (1Y4), U11.6 (1Y4)
LCD Reset: J10.11, J11.11, J12.11, U10.8 (1Y5), U11.8 (1Y5)
Motor: J10.6, J11.6, J12.6, U10.15 (2Y1), U11.15 (2Y1)
OS Enable Bus 1: R1.2, U10.14 (1Y10), U11.1 (1OE1), U11.56 (1OE2)
OS Enable Bus 2: R1.2, U10.27 (2Y10), U11.28 (2OE1), U11.29 (2OE2)
OS I2S_CLK: U11.34 (2A7)
OS I2S_DIN: U11.36 (2A6)
OS I2S_LRC: U11.33 (2A8)
OS LCD Backlight: U11.48 (1A6)
OS LCD CLK: U11.52 (1A3)
OS LCD CS: U11.54 (1A2)
OS LCD DC: U11.55 (1A1)
OS LCD DIN: U11.51 (1A4)
OS LCD Reset: U11.49 (1A5)
OS Motor: U11.42 (2A1)
OS SD CLK: U11.38 (2A4)
OS SD CS: U11.40 (2A3)
OS SD MISO: U11.41 (2A2)
OS SD MOSI: U11.37 (2A5)
SD CLK: J10.12, J11.12, J12.12, U10.19 (2Y4), U11.19 (2Y4)
SD CS: J10.10, J11.10, J12.10, U10.17 (2Y3), U11.17 (2Y3)
SD MISO: J10.8, J11.8, J12.8, U10.16 (2Y2), U11.16 (2Y2)
SD MOSI: J10.14, J11.14, J12.14, U10.20 (2Y5), U11.20 (2Y5)
User I2S_CLK: U10.34 (2A7)
User I2S_DIN: U10.36 (2A6)
User I2S_LRC: U10.33 (2A8)
User LCD Backlight: U10.48 (1A6)
User LCD CLK: U10.52 (1A3)
User LCD CS: U10.54 (1A2)
User LCD DC: U10.55 (1A1)
User LCD DIN: U10.51 (1A4)
User LCD Reset: U10.49 (1A5)
User Motor: U10.42 (2A1)
User SD CLK: U10.38 (2A4)
User SD CS: U10.40 (2A3)
User SD MISO: U10.41 (2A2)
User SD MOSI: U10.37 (2A5)
~User RUN: U10.28 (2OE1), U10.56 (1OE2)
~User Request Bus 1: U10.1 (1OE1)
~User Request Bus 2: U10.29 (2OE2)

Notes on the sheet:
User Buffer
OS Buffer
