BtheDestroyer/PICOnsole/KiCad/PICOnsole/debugging.kicad_sch

## KiCad design KiCad/PICOnsole/debugging.kicad_sch (2023-10-20)

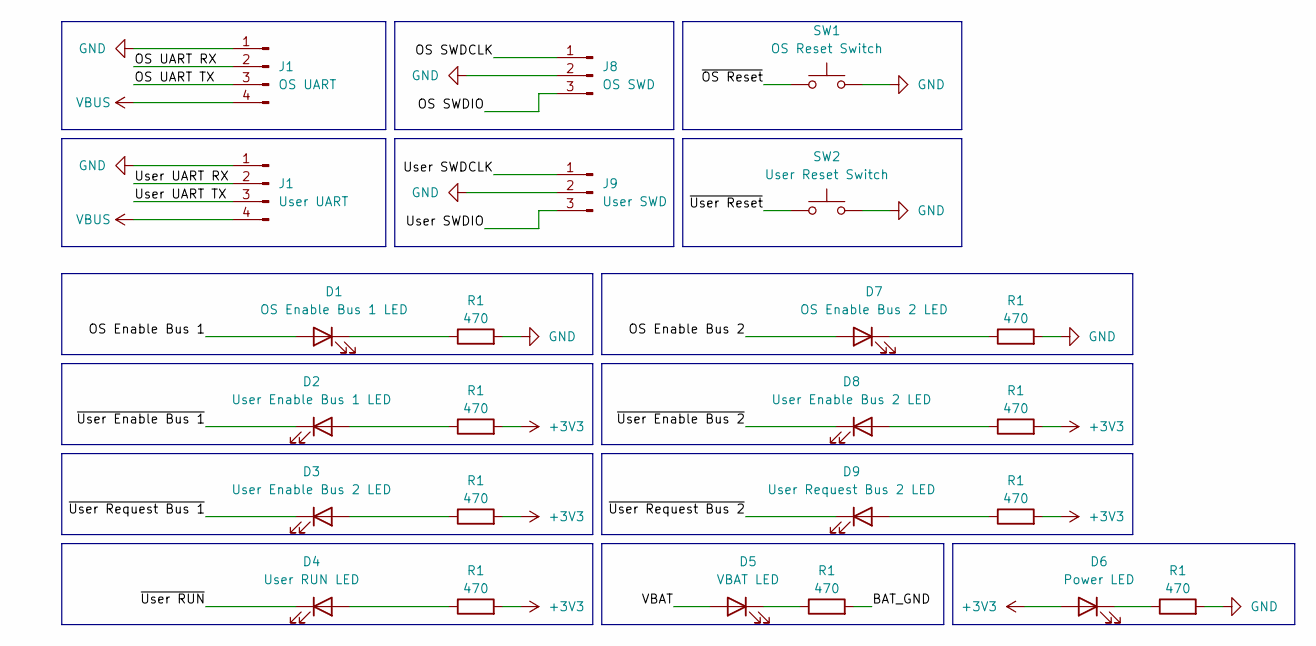
[picture p14: schematic debugging.kicad_sch]

Parts:
D1: OS Enable Bus 1 LED; LED_D5.0mm
D2: User Enable Bus 1 LED; LED_D5.0mm
D3, D8: User Enable Bus 2 LED; LED_D5.0mm
D4: User RUN LED; LED_D5.0mm
D5: VBAT LED; LED_D5.0mm
D6: Power LED; LED_D5.0mm
D7: OS Enable Bus 2 LED; LED_D5.0mm
D9: User Request Bus 2 LED; LED_D5.0mm
J1: OS UART; PinHeader_1x04_P2.54mm_Vertical
J8: OS SWD; PinHeader_1x03_P1.00mm_Vertical
J9: User SWD; PinHeader_1x03_P1.00mm_Vertical
R1: 470; R_0805_2012Metric
SW1: OS Reset Switch; SW_PUSH-12mm
SW2: User Reset Switch; SW_PUSH-12mm

Connections:
+3V3: D6.2 (A), R1.2
BAT_GND: R1.2
GND: J1.1, J8.2, J9.2, R1.2, SW1.2, SW2.2
unnamed: D1.1 (K), R1.1
unnamed: D2.2 (A), R1.1
unnamed: D3.2 (A), R1.1
unnamed: D4.2 (A), R1.1
unnamed: D5.1 (K), R1.1
unnamed: D6.1 (K), R1.1
unnamed: D7.1 (K), R1.1
unnamed: D8.2 (A), R1.1
unnamed: D9.2 (A), R1.1
OS Enable Bus 1: D1.2 (A)
OS Enable Bus 2: D7.2 (A)
OS SWDCLK: J8.1
OS SWDIO: J8.3
OS UART RX: J1.2
OS UART TX: J1.3
User SWDCLK: J9.1
User SWDIO: J9.3
User UART RX: J1.2
User UART TX: J1.3
VBAT: D5.2 (A)
VBUS: J1.4
~OS Reset: SW1.1
~User Enable Bus 1: D2.1 (K)
~User Enable Bus 2: D8.1 (K)
~User RUN: D4.1 (K)
~User Request Bus 1: D3.1 (K)
~User Request Bus 2: D9.1 (K)
~User Reset: SW2.1
