BtheDestroyer/PICOnsole/KiCad/PICOnsole/feedback.kicad_sch

## KiCad design KiCad/PICOnsole/feedback.kicad_sch (2023-10-20)

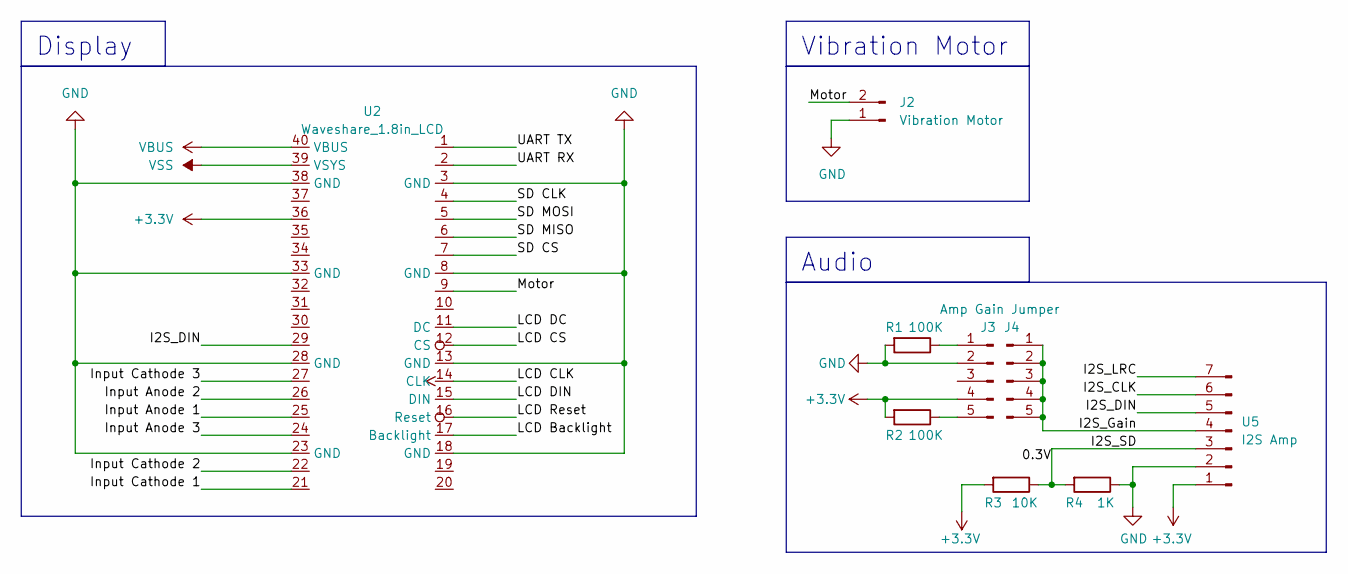
[picture p15: schematic feedback.kicad_sch]

Parts:
J2: Vibration Motor; PinHeader_1x02_P2.54mm_Vertical
J3: Amp Gain Jumper; PinHeader_1x05_P2.54mm_Vertical
J4: Amp Gain Jumper2; PinHeader_1x05_P2.54mm_Vertical
R1, R2: 100K; R_0805_2012Metric_Pad1.20x1.40mm_HandSolder
R3: 10K; R_0805_2012Metric_Pad1.20x1.40mm_HandSolder
R4: 1K; R_0805_2012Metric_Pad1.20x1.40mm_HandSolder
U2: Waveshare_1.8in_LCD
U5: I2S Amp; PinHeader_1x07_P2.54mm_Vertical

Connections:
0.3V: R3.1, R4.2, U5.3
+3.3V: J3.4, R2.2, R3.2, U2.36, U5.1
GND: J2.1, J3.2, R1.2, R4.1, U2.3 (GND), U2.8 (GND), U2.13 (GND), U2.18 (GND), U2.23 (GND), U2.28 (GND), U2.33 (GND), U2.38 (GND), U5.2
I2S_CLK: U5.6
I2S_DIN: U2.29, U5.5
I2S_Gain: J4.1, J4.2, J4.3, J4.4, J4.5, U5.4
I2S_LRC: U5.7
Input Anode 1: U2.25
Input Anode 2: U2.26
Input Anode 3: U2.24
Input Cathode 1: U2.21
Input Cathode 2: U2.22
Input Cathode 3: U2.27
LCD Backlight: U2.17 (Backlight)
LCD CLK: U2.14 (CLK)
LCD CS: U2.12 (CS)
LCD DC: U2.11 (DC)
LCD DIN: U2.15 (DIN)
LCD Reset: U2.16 (Reset)
Motor: J2.2, U2.9
unnamed: J3.1, R1.1
unnamed: J3.5, R2.1
SD CLK: U2.4
SD CS: U2.7
SD MISO: U2.6
SD MOSI: U2.5
UART RX: U2.2
UART TX: U2.1
VBUS: U2.40 (VBUS)
VSS: U2.39 (VSYS)

Notes on the sheet:
Audio
Display
Vibration Motor
