BtheDestroyer/PICOnsole/KiCad/PICOnsole/os_pico.kicad_sch

## KiCad design KiCad/PICOnsole/os_pico.kicad_sch (2023-10-20)

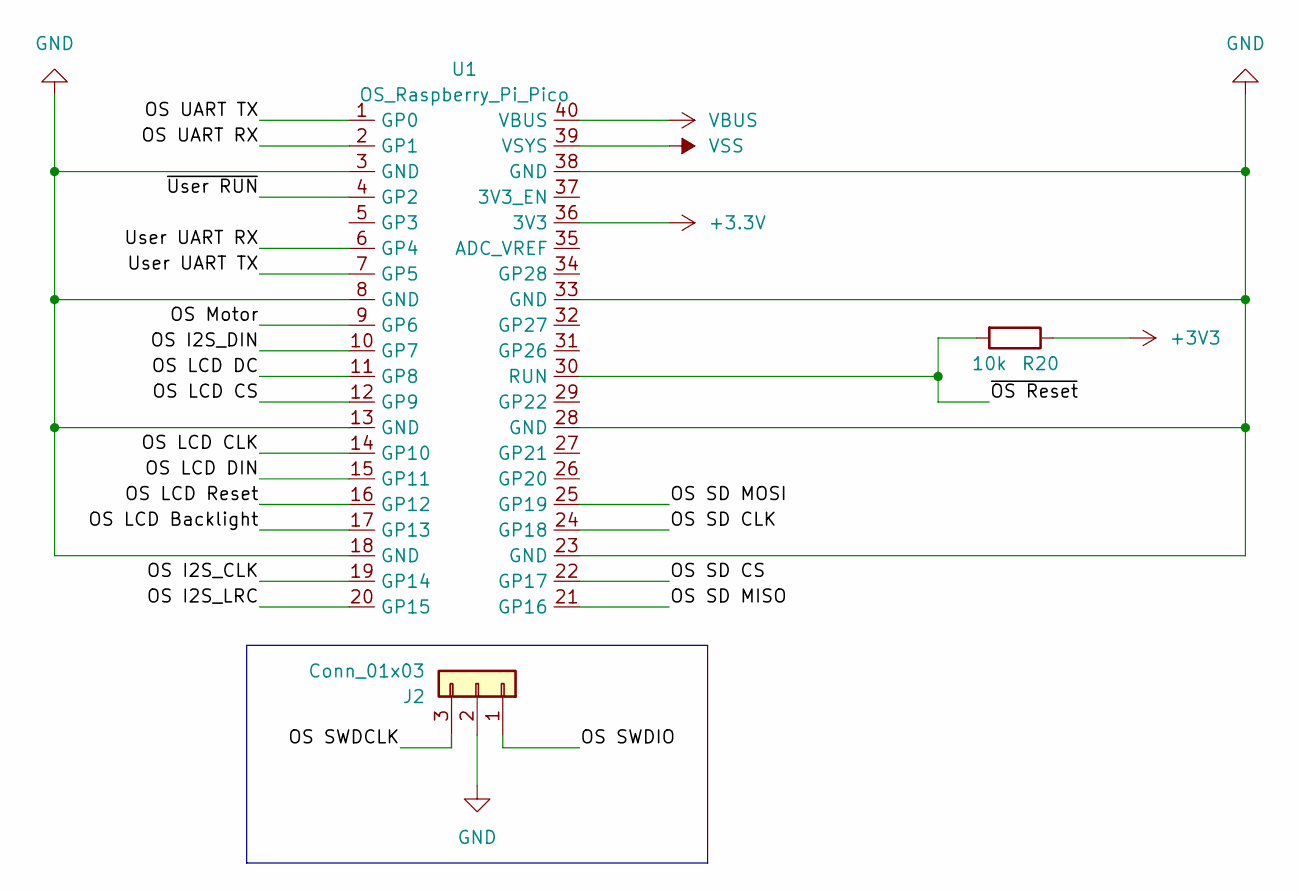
[picture p16: schematic os_pico.kicad_sch]

Parts:
J2: Conn_01x03; PinHeader_1x03_P2.54mm_Vertical
R20: 10k; R_0805_2012Metric
U1: OS_Raspberry_Pi_Pico; Raspberry_Pi_Pico

Connections:
+3.3V: U1.36 (3V3)
+3V3: R20.1
GND: J2.2, U1.3 (GND), U1.8 (GND), U1.13 (GND), U1.18 (GND), U1.23 (GND), U1.28 (GND), U1.33 (GND), U1.38 (GND)
OS I2S_CLK: U1.19 (GP14)
OS I2S_DIN: U1.10 (GP7)
OS I2S_LRC: U1.20 (GP15)
OS LCD Backlight: U1.17 (GP13)
OS LCD CLK: U1.14 (GP10)
OS LCD CS: U1.12 (GP9)
OS LCD DC: U1.11 (GP8)
OS LCD DIN: U1.15 (GP11)
OS LCD Reset: U1.16 (GP12)
OS Motor: U1.9 (GP6)
OS SD CLK: U1.24 (GP18)
OS SD CS: U1.22 (GP17)
OS SD MISO: U1.21 (GP16)
OS SD MOSI: U1.25 (GP19)
OS SWDCLK: J2.3
OS SWDIO: J2.1
OS UART RX: U1.2 (GP1)
OS UART TX: U1.1 (GP0)
User UART RX: U1.6 (GP4)
User UART TX: U1.7 (GP5)
VBUS: U1.40 (VBUS)
VSS: U1.39 (VSYS)
~OS Reset: R20.2, U1.30 (RUN)
~User RUN: U1.4 (GP2)
