BtheDestroyer/PICOnsole/KiCad/PICOnsole/os_sector.kicad_sch

## KiCad design KiCad/PICOnsole/os_sector.kicad_sch (2023-10-20)

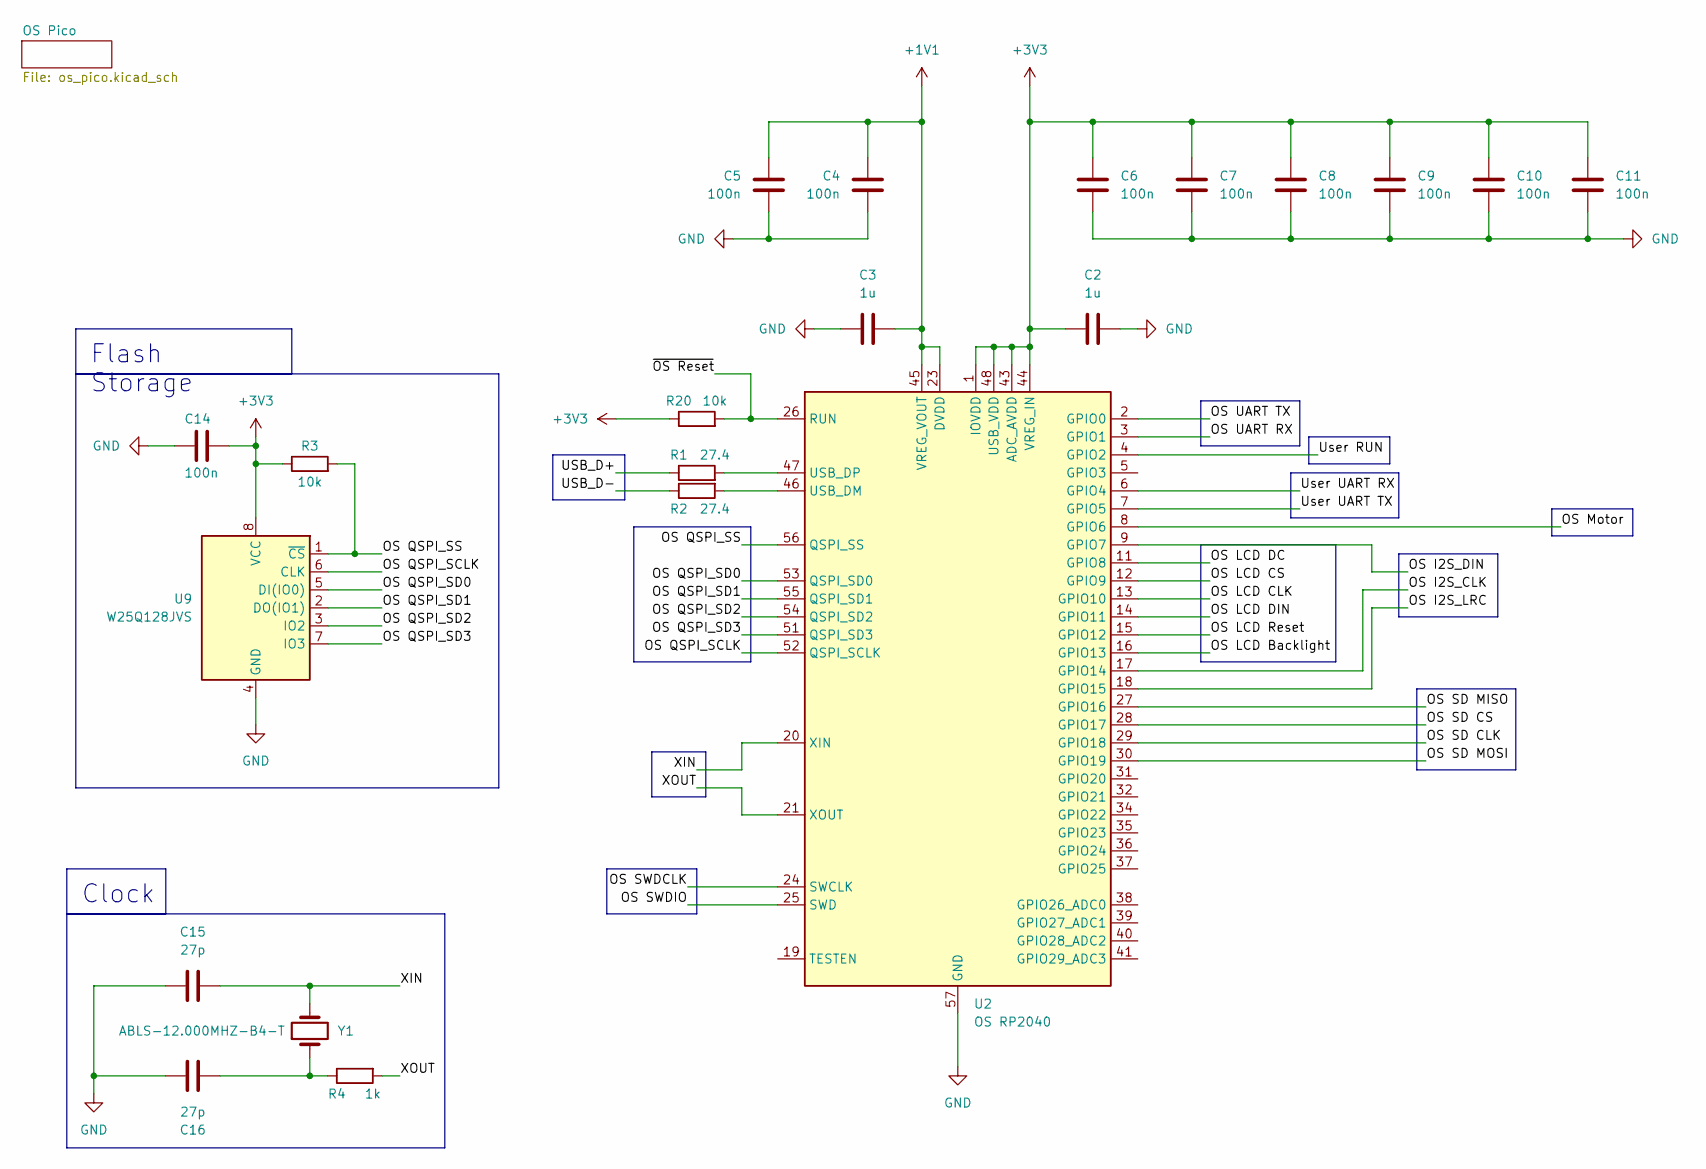
[picture p17: schematic os_sector.kicad_sch]

Parts:
C2, C3: 1u; C_0805_2012Metric
C4, C5, C6, C7, C8, C9, C10, C11, C14: 100n; C_0805_2012Metric
C15, C16: 27p; C_0805_2012Metric
R1, R2: 27.4; R_0805_2012Metric
R3, R20: 10k; R_0805_2012Metric
R4: 1k; R_0805_2012Metric
U2: OS RP2040; QFN-56-1EP_7x7mm_P0.4mm_EP3.2x3.2mm
U9: W25Q128JVS; SOIC-8_5.23x5.23mm_P1.27mm
Y1: ABLS-12.000MHZ-B4-T; Crystal_SMD_Abracon_ABM3-2Pin_5.0x3.2mm

Connections:
+1V1: C3.2, C4.1, C5.1, U2.23 (DVDD), U2.45 (VREG_VOUT), U2.50 (DVDD)
+3V3: C2.1, C6.1, C7.1, C8.1, C9.1, C10.1, C11.1, C14.1, R3.1, R20.1, U2.1 (IOVDD), U2.10 (IOVDD), U2.22 (IOVDD), U2.33 (IOVDD), U2.42 (IOVDD), U2.43 (ADC_AVDD), U2.44 (VREG_IN), U2.48 (USB_VDD), U2.49 (IOVDD), U9.8 (VCC)
GND: C2.2, C3.1, C4.2, C5.2, C6.2, C7.2, C8.2, C9.2, C10.2, C11.2, C14.2, C15.2, C16.1, U2.57 (GND), U9.4 (GND)
unnamed: C16.2, R4.1, Y1.1
unnamed: R1.2, U2.47 (USB_DP)
unnamed: R2.2, U2.46 (USB_DM)
OS I2S_CLK: U2.17 (GPIO14)
OS I2S_DIN: U2.9 (GPIO7)
OS I2S_LRC: U2.18 (GPIO15)
OS LCD Backlight: U2.16 (GPIO13)
OS LCD CLK: U2.13 (GPIO10)
OS LCD CS: U2.12 (GPIO9)
OS LCD DC: U2.11 (GPIO8)
OS LCD DIN: U2.14 (GPIO11)
OS LCD Reset: U2.15 (GPIO12)
OS Motor: U2.8 (GPIO6)
OS QSPI_SCLK: U2.52 (QSPI_SCLK), U9.6 (CLK)
OS QSPI_SD0: U2.53 (QSPI_SD0), U9.5 (DI(IO0))
OS QSPI_SD1: U2.55 (QSPI_SD1), U9.2 (DO(IO1))
OS QSPI_SD2: U2.54 (QSPI_SD2), U9.3 (IO2)
OS QSPI_SD3: U2.51 (QSPI_SD3), U9.7 (IO3)
OS QSPI_SS: R3.2, U2.56 (QSPI_SS), U9.1 (~CS)
OS SD CLK: U2.29 (GPIO18)
OS SD CS: U2.28 (GPIO17)
OS SD MISO: U2.27 (GPIO16)
OS SD MOSI: U2.30 (GPIO19)
OS SWDCLK: U2.24 (SWCLK)
OS SWDIO: U2.25 (SWD)
OS UART RX: U2.3 (GPIO1)
OS UART TX: U2.2 (GPIO0)
USB_D+: R1.1
USB_D-: R2.1
User RUN: U2.4 (GPIO2)
User UART RX: U2.6 (GPIO4)
User UART TX: U2.7 (GPIO5)
XIN: C15.1, U2.20 (XIN), Y1.2
XOUT: R4.2, U2.21 (XOUT)
~OS Reset: R20.2, U2.26 (RUN)

Notes on the sheet:
Flash Storage
Clock
