BtheDestroyer/PICOnsole/KiCad/PICOnsole/powersupply.kicad_sch

## KiCad design KiCad/PICOnsole/powersupply.kicad_sch (2023-10-20)

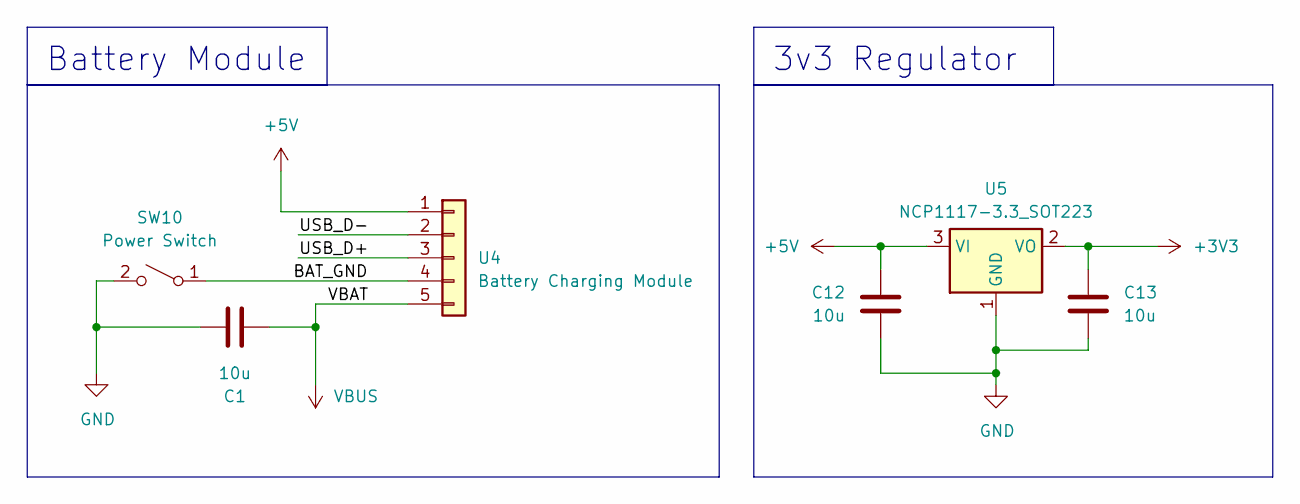
[picture p18: schematic powersupply.kicad_sch]

Parts:
C1, C12, C13: 10u; C_0805_2012Metric
SW10: Power Switch; PinHeader_1x03_P2.54mm_Vertical
U4: Battery Charging Module; PinHeader_1x05_P2.54mm_Vertical
U5: NCP1117-3.3_SOT223; SOT-223-3_TabPin2

Connections:
+3V3: C13.1, U5.2 (VO)
+5V: C12.1, U4.1, U5.3 (VI)
BAT_GND: SW10.1 (A), U4.4
GND: C1.2, C12.2, C13.2, SW10.2 (B), U5.1 (GND)
USB_D+: U4.3
USB_D-: U4.2
VBUS: C1.1, U4.5

Notes on the sheet:
3v3 Regulator
Battery Module
