BtheDestroyer/PICOnsole/KiCad/PICOnsole/user_pico.kicad_sch

## KiCad design KiCad/PICOnsole/user_pico.kicad_sch (2023-10-20)

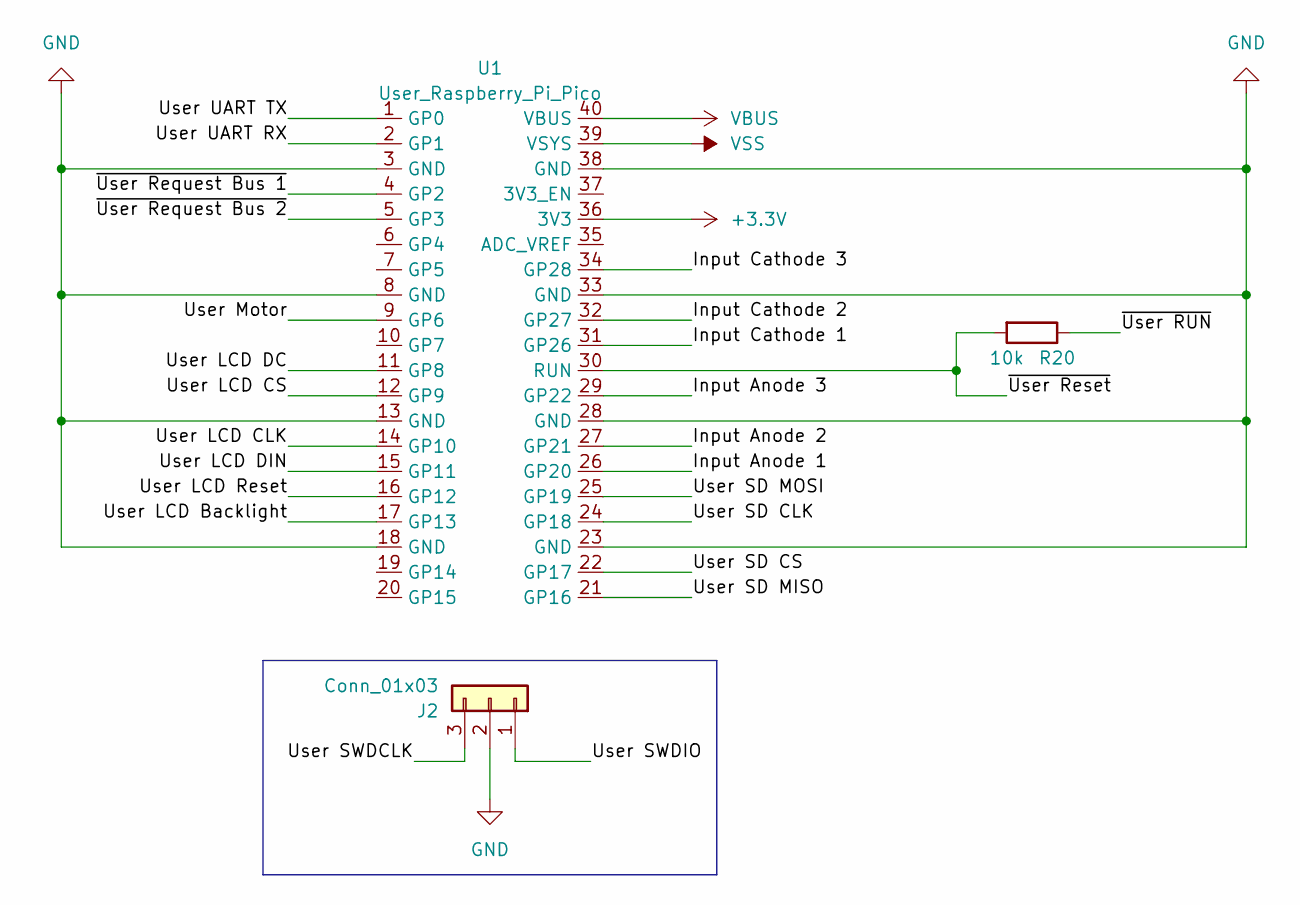
[picture p19: schematic user_pico.kicad_sch]

Parts:
J2: Conn_01x03; PinHeader_1x03_P2.54mm_Vertical
R20: 10k; R_0805_2012Metric
U1: User_Raspberry_Pi_Pico; Raspberry_Pi_Pico

Connections:
+3.3V: U1.36 (3V3)
GND: J2.2, U1.3 (GND), U1.8 (GND), U1.13 (GND), U1.18 (GND), U1.23 (GND), U1.28 (GND), U1.33 (GND), U1.38 (GND)
Input Anode 1: U1.26 (GP20)
Input Anode 2: U1.27 (GP21)
Input Anode 3: U1.29 (GP22)
Input Cathode 1: U1.31 (GP26)
Input Cathode 2: U1.32 (GP27)
Input Cathode 3: U1.34 (GP28)
User LCD Backlight: U1.17 (GP13)
User LCD CLK: U1.14 (GP10)
User LCD CS: U1.12 (GP9)
User LCD DC: U1.11 (GP8)
User LCD DIN: U1.15 (GP11)
User LCD Reset: U1.16 (GP12)
User Motor: U1.9 (GP6)
User SD CLK: U1.24 (GP18)
User SD CS: U1.22 (GP17)
User SD MISO: U1.21 (GP16)
User SD MOSI: U1.25 (GP19)
User SWDCLK: J2.3
User SWDIO: J2.1
User UART RX: U1.2 (GP1)
User UART TX: U1.1 (GP0)
VBUS: U1.40 (VBUS)
VSS: U1.39 (VSYS)
~User RUN: R20.1
~User Request Bus 1: U1.4 (GP2)
~User Request Bus 2: U1.5 (GP3)
~User Reset: R20.2, U1.30 (RUN)
