BtheDestroyer/PICOnsole/os/inc/PICOnsole.h

#pragma once
#include "PICOnsole_defines.h"
#include "debug.h"
#include "OS.h"
#include "path.h"
#include "program.h"
#include "interfaces/Input.h"
#include "interfaces/LCD.h"
#include "interfaces/SD.h"
#include "interfaces/Speaker.h"
#include "interfaces/Vibrator.h"
#include "gfx/color.h"
#include "gfx/sprite.h"
#include "gfx/text.h"
#include "gfx/typeface.h"
#include "gfx/typefaces/ascii_5px.h"
