BtheDestroyer/PICOnsole/(commit log)

2023-02-04 Proof of concept stage
2023-02-07 Loading and launching ELF correctly, but calling libc functions results in a hardfault...
    [OS.cpp, OS.h, SD.h, main.cpp, program.h]
2023-03-22 Started work on Audio Speaker+Vibration motor; Started PCB design
    [PICOnsole.kicad_pcb, PICOnsole.kicad_sch]
2023-03-26 Buttons/input now functional. Added input_test program
2023-04-06 Updated CAD files
    [PICOnsole-B_Cu.gbr, PICOnsole-B_Mask.gbr, PICOnsole-B_Paste.gbr, PICOnsole-B_Silkscreen.gbr, PICOnsole-Edge_Cuts.gbr, PICOnsole-F_Cu.gbr, PICOnsole-F_Mask.gbr, PICOnsole-F_Paste.gbr]
2023-04-07 Increased OS RAM size to allow for better errors. Currently programs can't find builtin functions (eg memset) correctly
    [PICOnsole.kicad_pcb, PICOnsole.kicad_sch]
2023-10-20 Moved KiCad files to KiCad folder; Started new revision of project with 2 Picos
    [DevkitHotswapPicoHub-B_Cu.gbr, DevkitHotswapPicoHub-B_Mask.gbr, DevkitHotswapPicoHub-B_Paste.gbr, DevkitHotswapPicoHub-B_Silkscreen.gbr, DevkitHotswapPicoHub-Edge_Cuts.gbr, DevkitHotswapPicoHub-F_Cu.gbr, DevkitHotswapPicoHub-F_Mask.gbr, DevkitHotswapPicoHub-F_Paste.gbr]
2023-11-23 Updated KiCad to V1.1.2
    [DPad.blend, DPad.stl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]
