BtheDestroyer/PICOnsole/(notices)

Notices in the files:
KiCad/Devkit/Handheld Interface/HandheldInterface.kicad_pcb:
© Bryce Dixon
